garrettsworkshop/WarpSE/Documentation/Breakdown.png

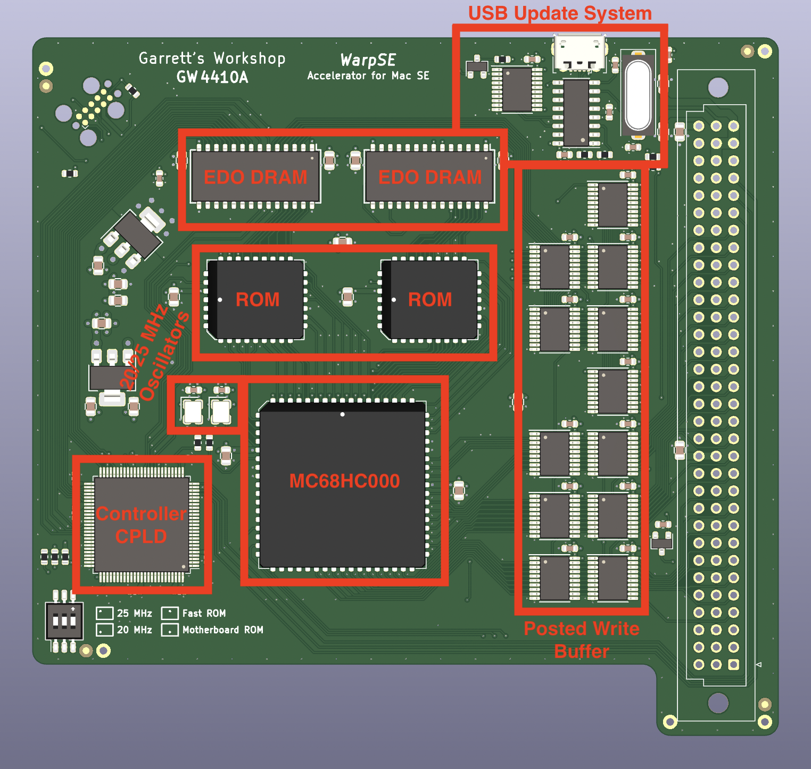
Documentation/Breakdown.png
