garrettsworkshop/WarpSE/Documentation/CPLD.png

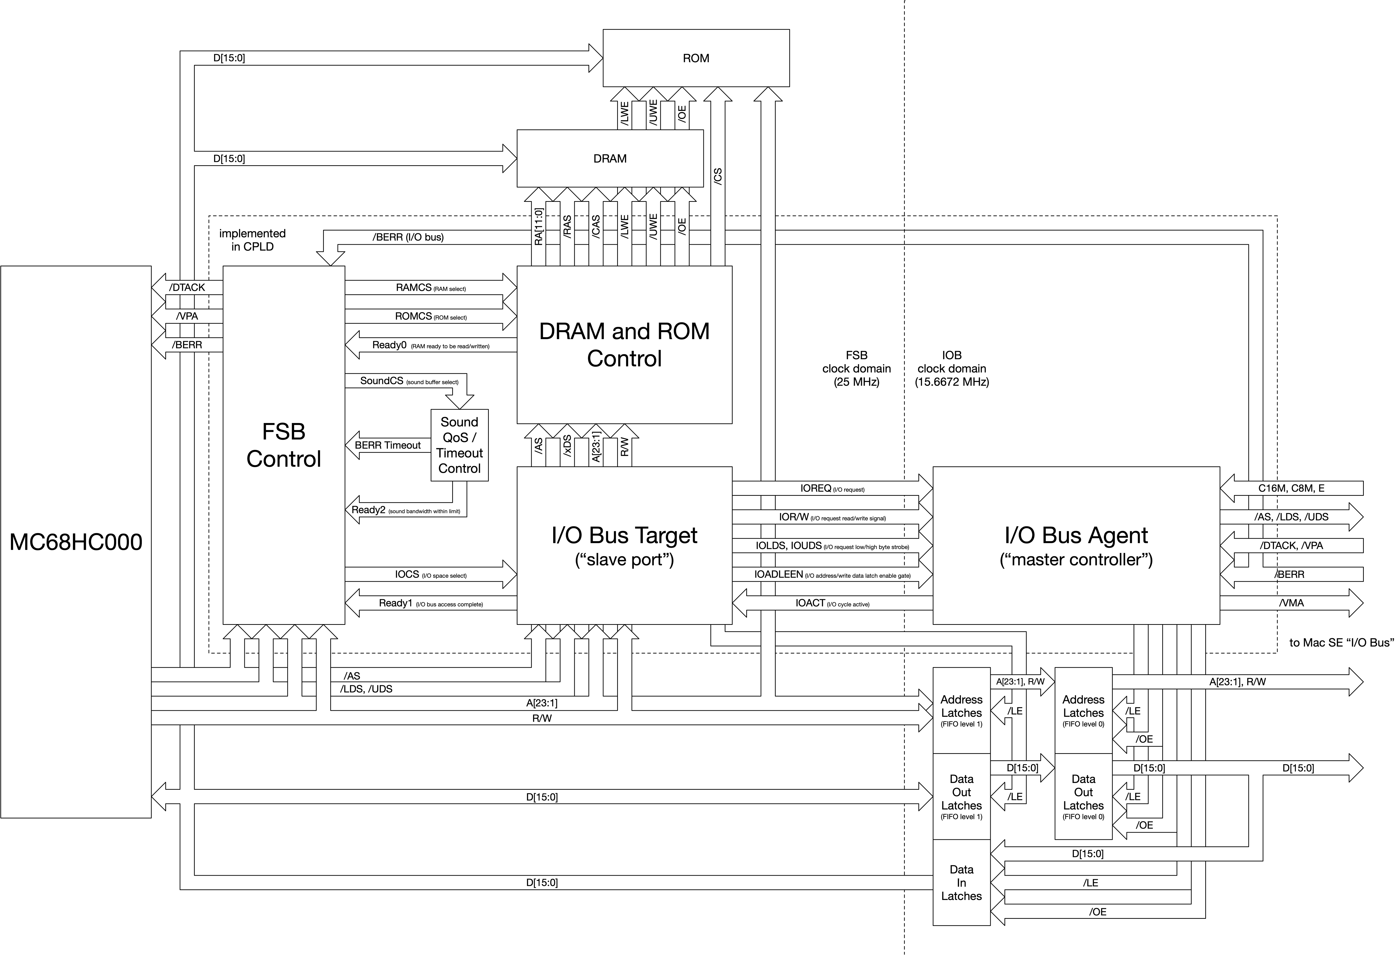
Documentation/CPLD.png
