garrettsworkshop/WarpSE/Documentation/FrontIsom.png

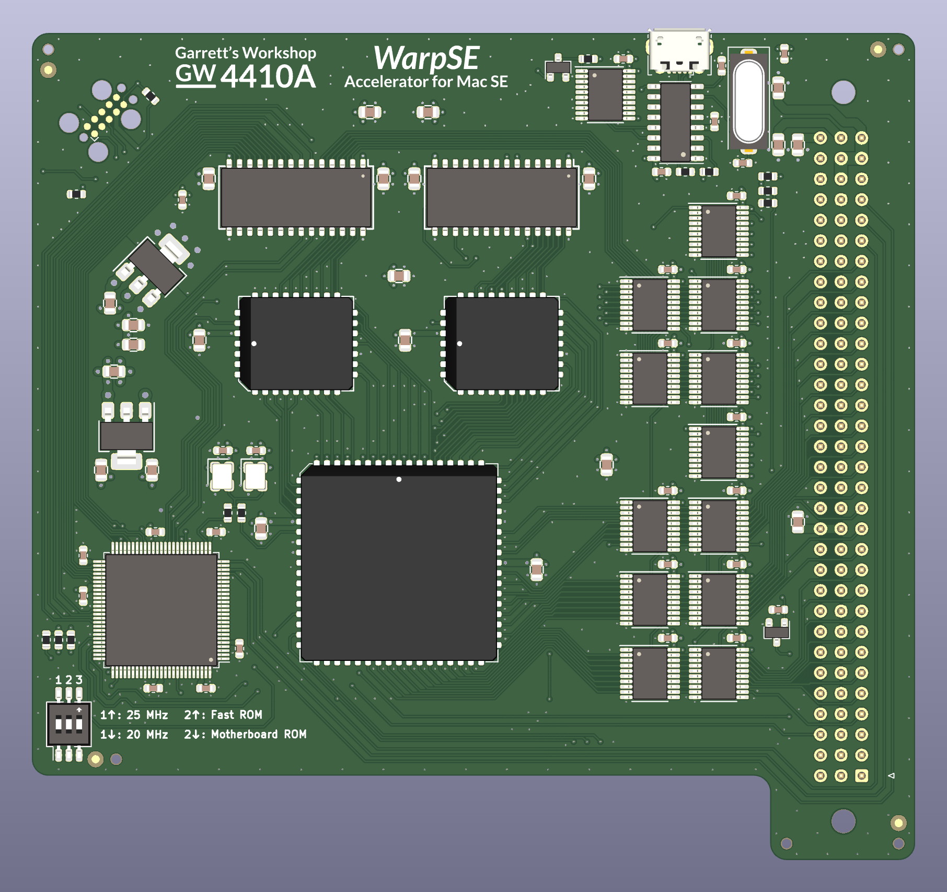
Documentation/FrontIsom.png
