garrettsworkshop/WarpSE/Documentation/WarpSE.4410A-Schematic.pdf

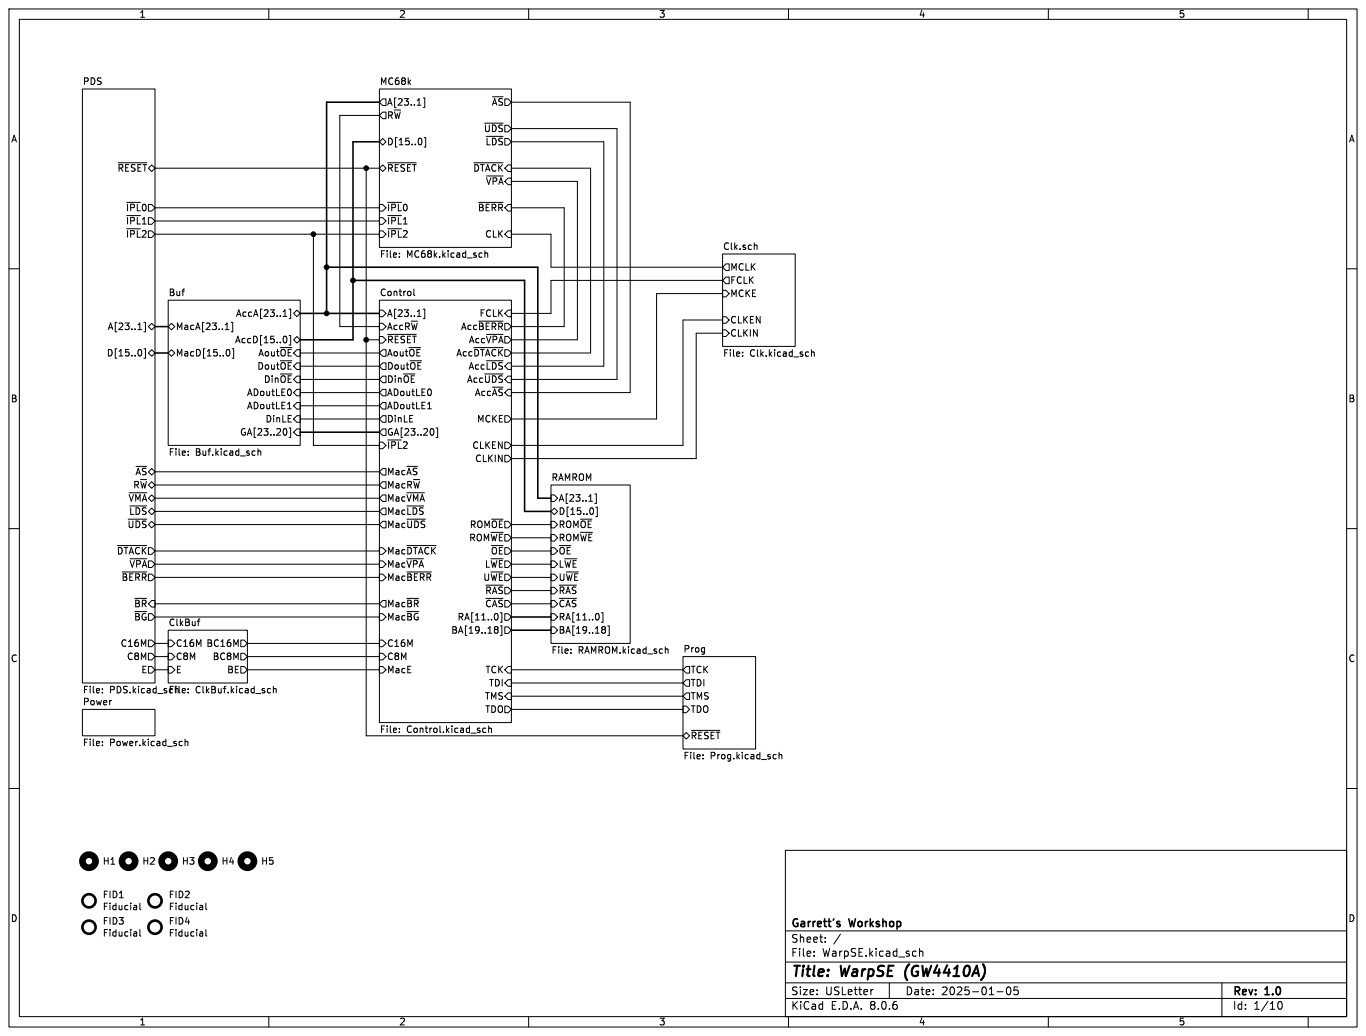
[picture p4: page 1]

Clk.sch File: Clk.kicad_sch A[23..1]
ClkBuf File: ClkBuf.kicad_sch AccA[23..1]
MacA[23..1]

Prog File: Prog.kicad_sch MCLK
FCLK MCKE CLKIN

Aout~{OE} ADoutLE0 ADoutLE1 GA[23..20] Buf File: Buf.kicad_sch A[23..1]

Aout~{OE}
ROM~{OE} DinLE Dout~{OE}
Din~{OE}

Id: 1/10 Title: WarpSE (GW4410A) File: WarpSE.kicad_sch Sheet: / Garrett's Workshop

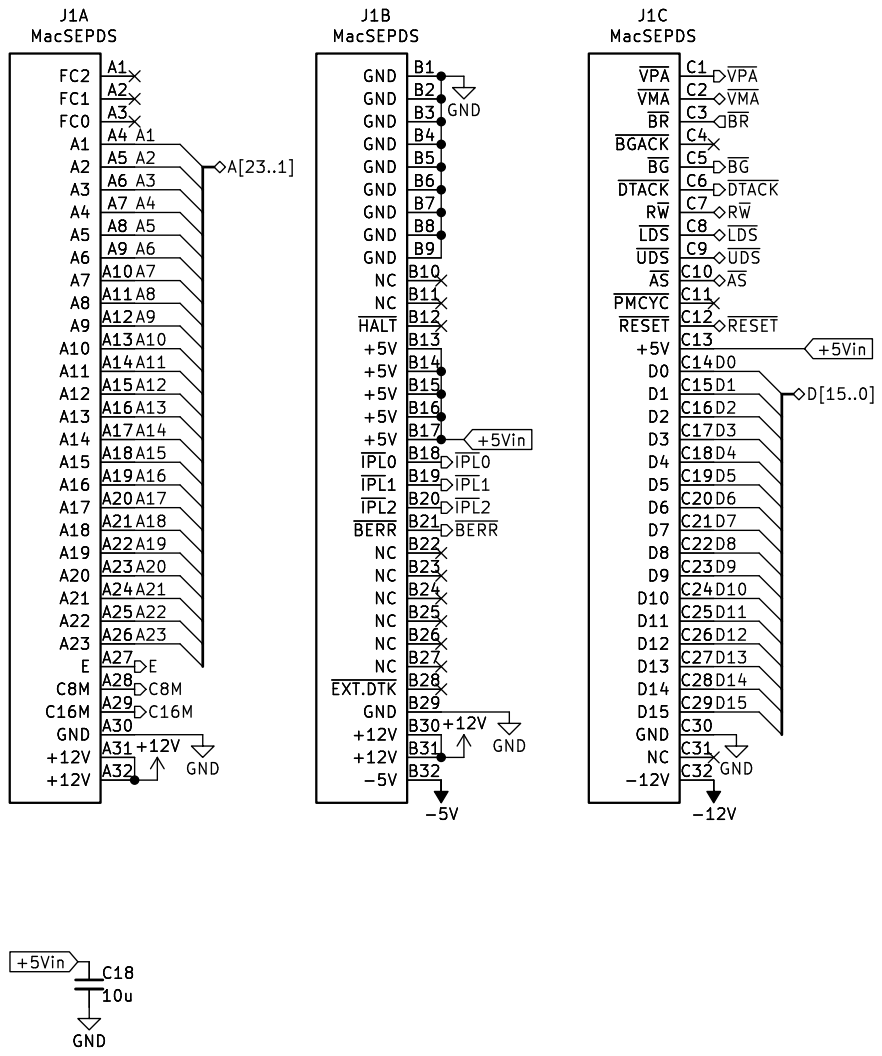
[picture p5: page 2]

Id: 2/10 Title: WarpSE (GW4410A) File: PDS.kicad_sch Sheet: /PDS/ Garrett's Workshop GND

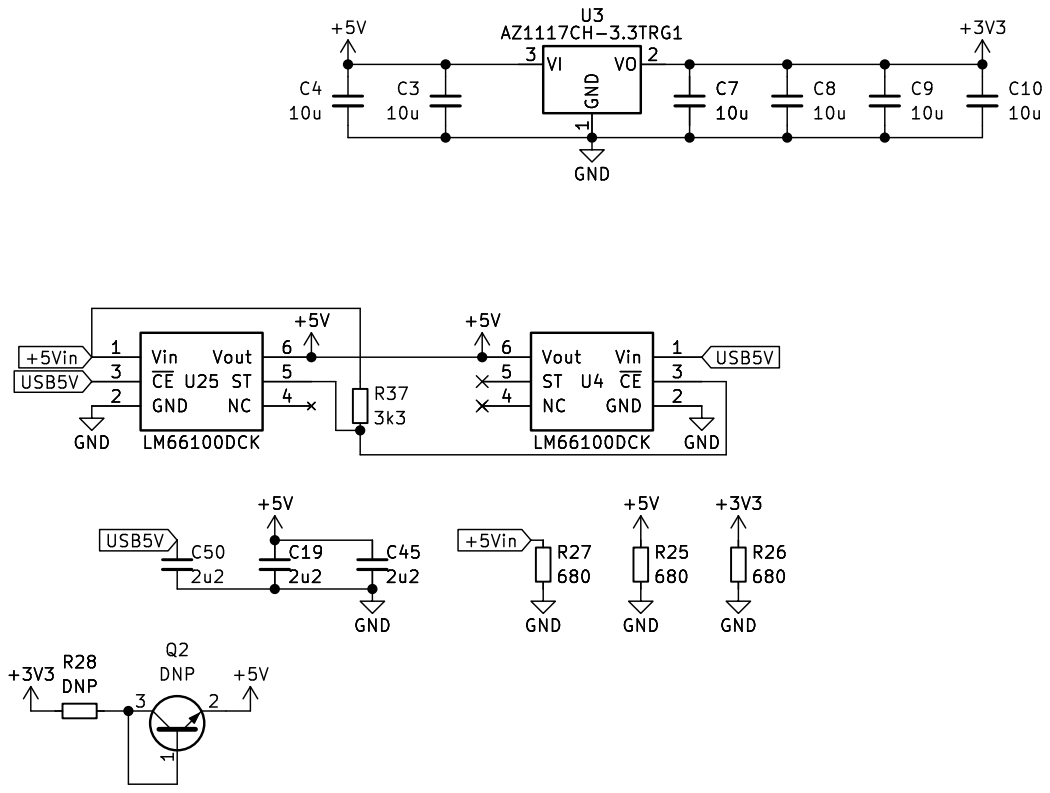
[picture p6: page 3]

Id: 3/10 Title: WarpSE (GW4410A) File: Power.kicad_sch Sheet: /Power/ Garrett's Workshop

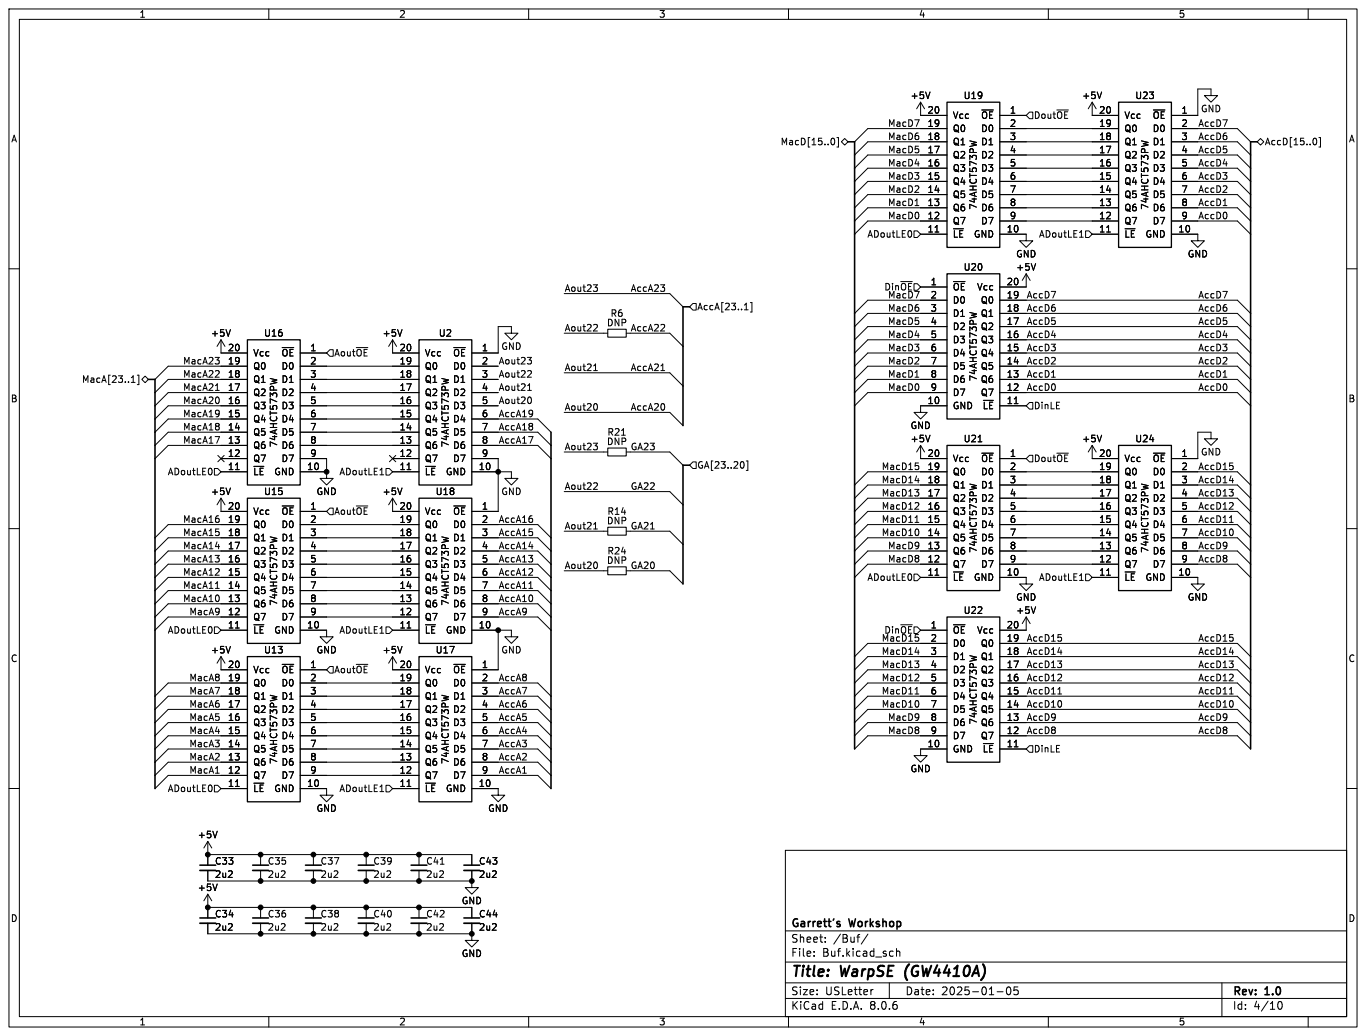
[picture p7: page 4]

Id: 4/10 Title: WarpSE (GW4410A) File: Buf.kicad_sch Sheet: /Buf/ Garrett's Workshop

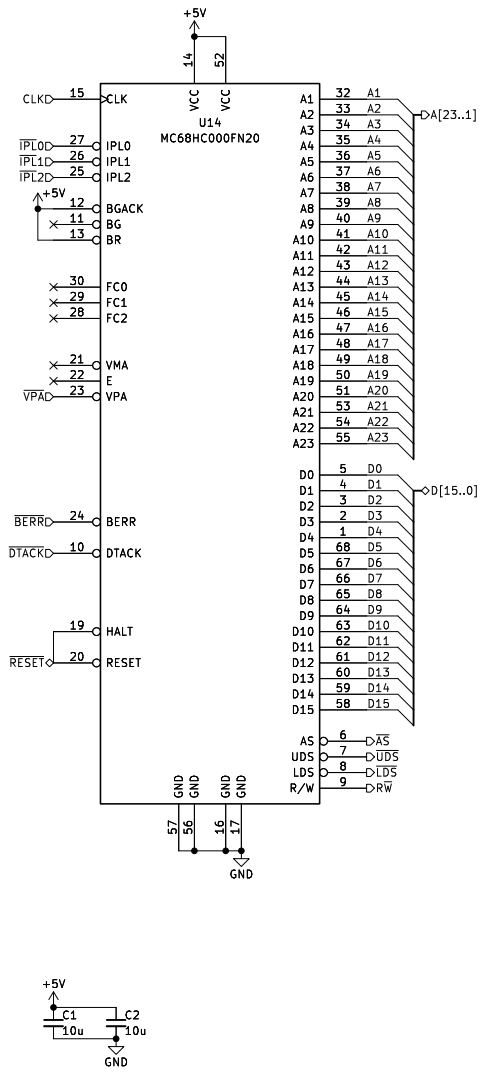
[picture p8: page 5]

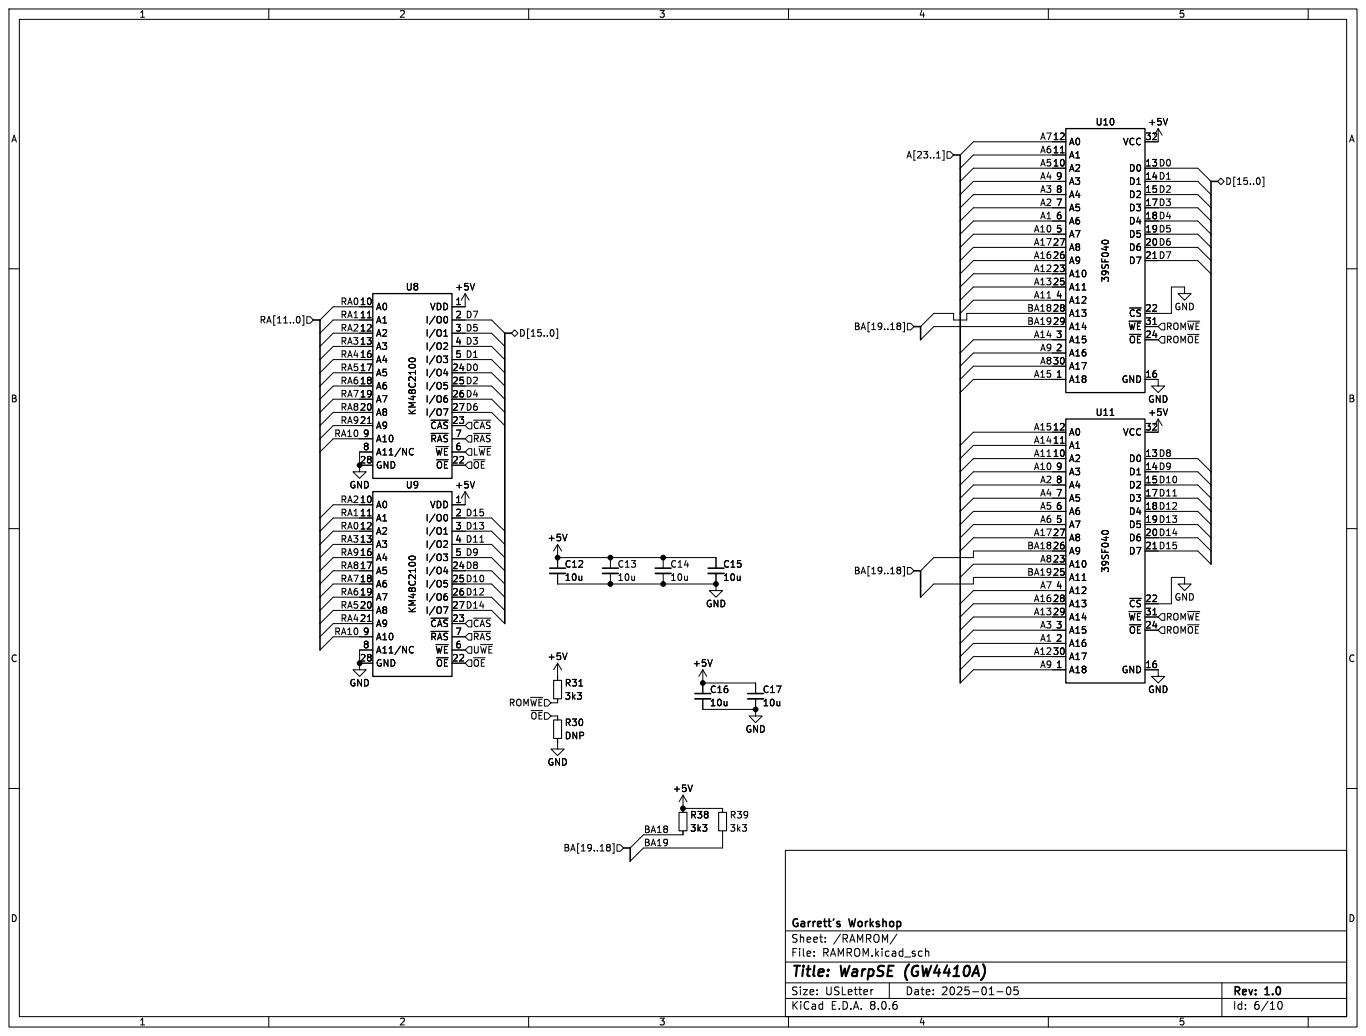
[picture p9: page 6]

Id: 6/10 Title: WarpSE (GW4410A) File: RAMROM.kicad_sch Sheet: /RAMROM/ Garrett's Workshop

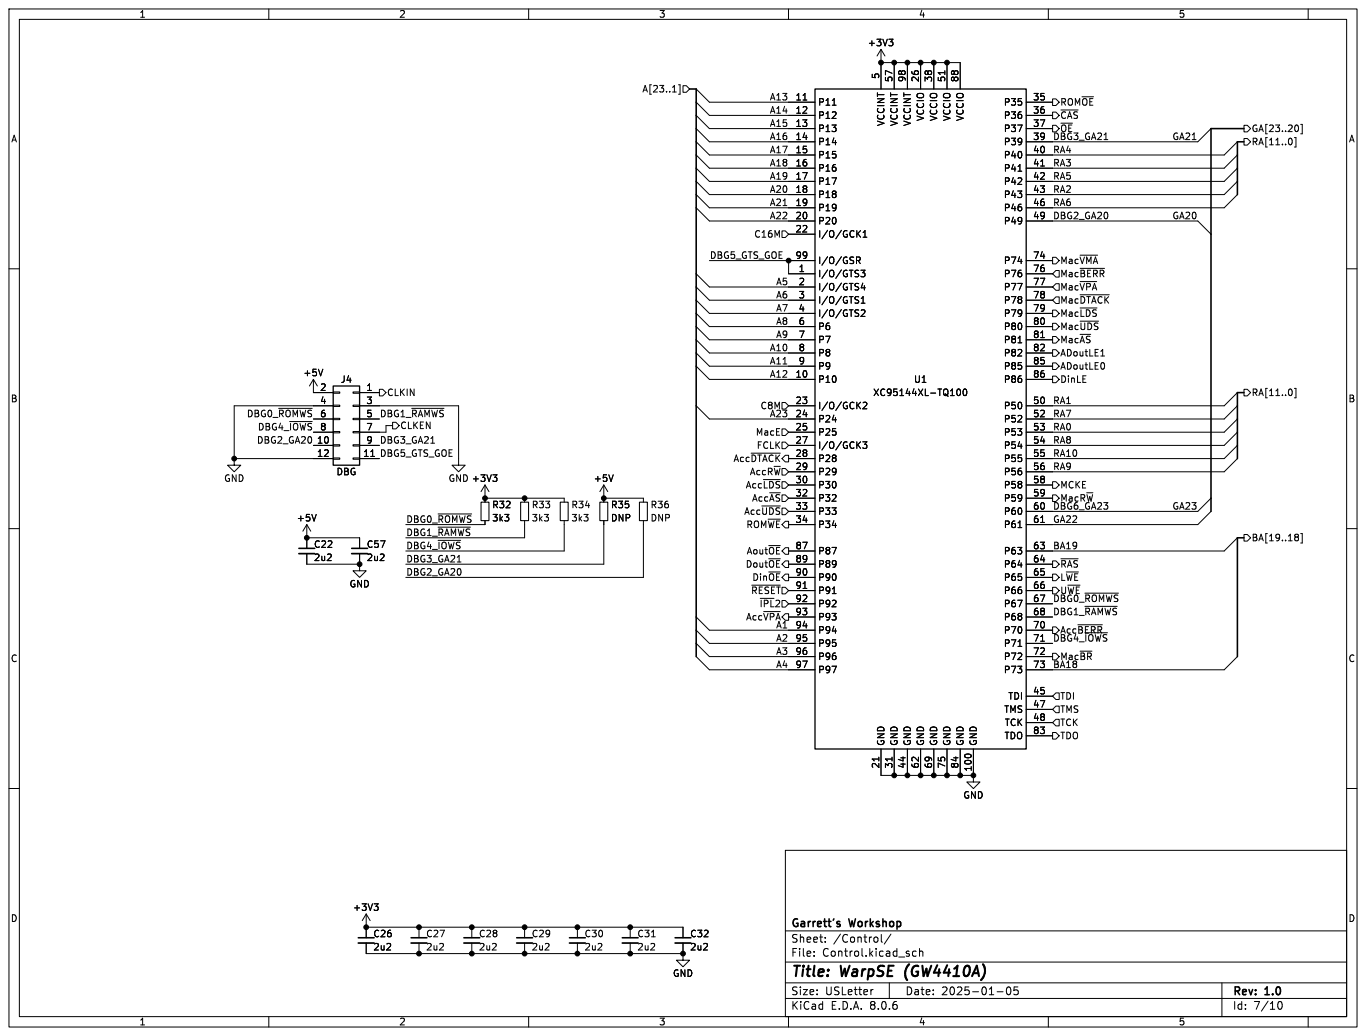
[picture p10: page 7]

Mac~{VMA}
Mac~{BERR} ADoutLE1 Mac~{LDS}
Mac~{VPA}
Mac~{DTACK}

BA[19..18] TDI Mac~{AS} TDO

Id: 7/10 Title: WarpSE (GW4410A) File: Control.kicad_sch Sheet: /Control/ Garrett's Workshop C27

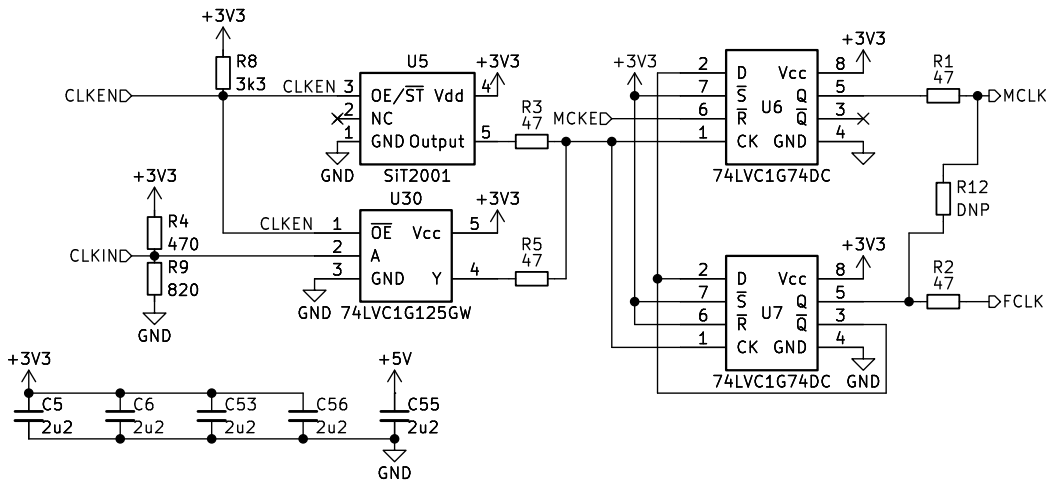
[picture p11: page 8]

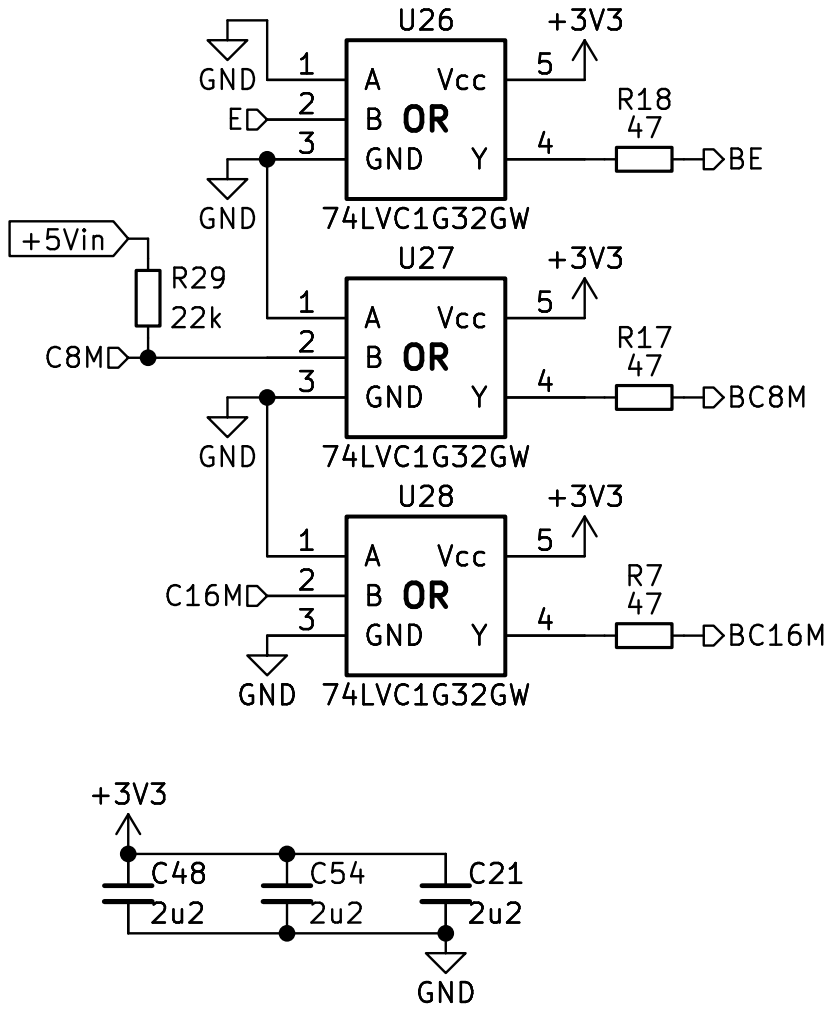
[picture p12: page 9]

74LVC1G32GW
Id: 10/10 Title: WarpSE (GW4410A) File: ClkBuf.kicad_sch Sheet: /ClkBuf/ Garrett's Workshop OR

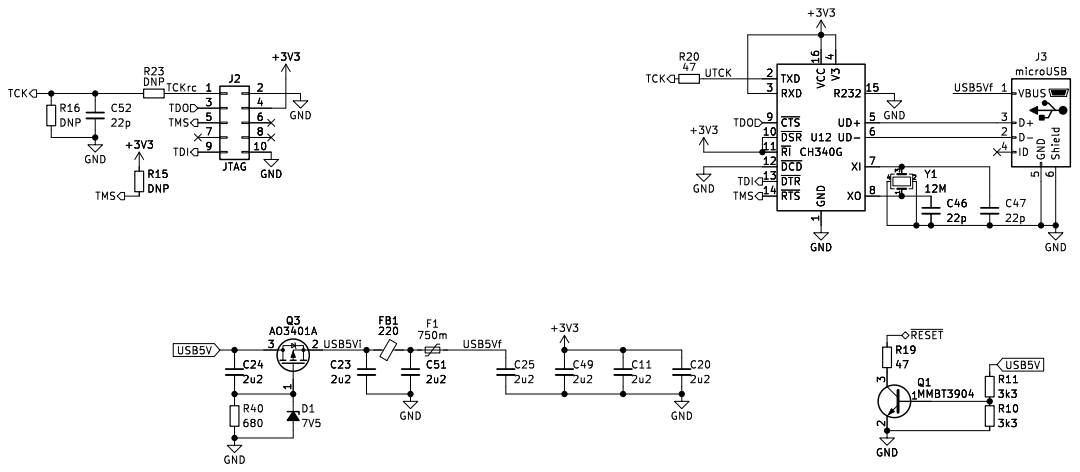
[picture p13: page 10]

1 ~{DSR} 10 ~{RI} 11 ~{DCD} 12 ~{DTR} 13 ~{RTS} 14 R232 VCC 15 16 TXD 2 RXD 3 V3

4 UD+ 5 UD- 6 XI 7 XO 8 ~{CTS} 9 U12 CH340G

4 UD+ 5 UD- 6 XI 7 XO 8 ~{CTS} 9

Id: 10/10 Title: WarpSE (GW4410A) File: Prog.kicad_sch Sheet: /Prog/ Garrett's Workshop
