garrettsworkshop/WarpSE/Documentation/WarpSE.4410A-Placement.pdf

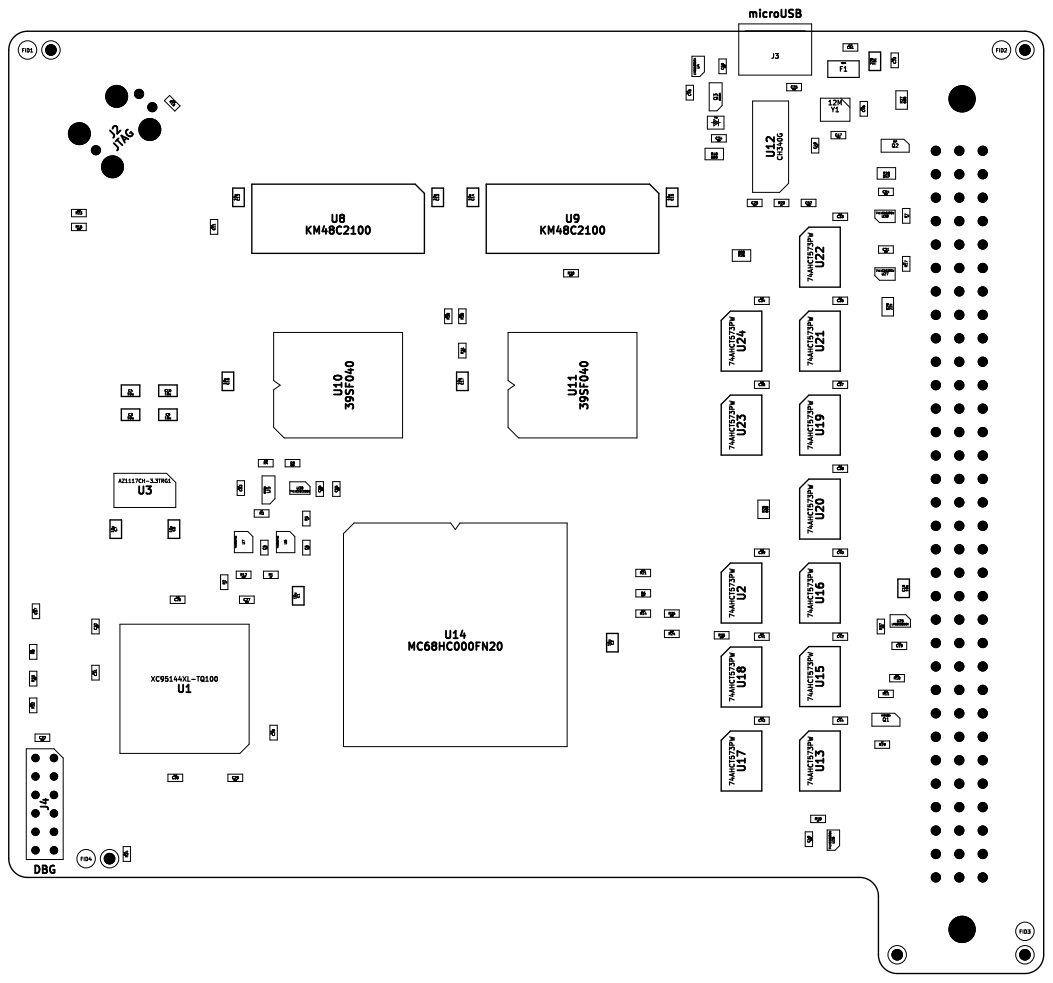
[picture p14: page 1]
