garrettsworkshop/WarpSE/WarpSE.kicad_pcb

## KiCad design WarpSE.kicad_pcb (2025-01-10)

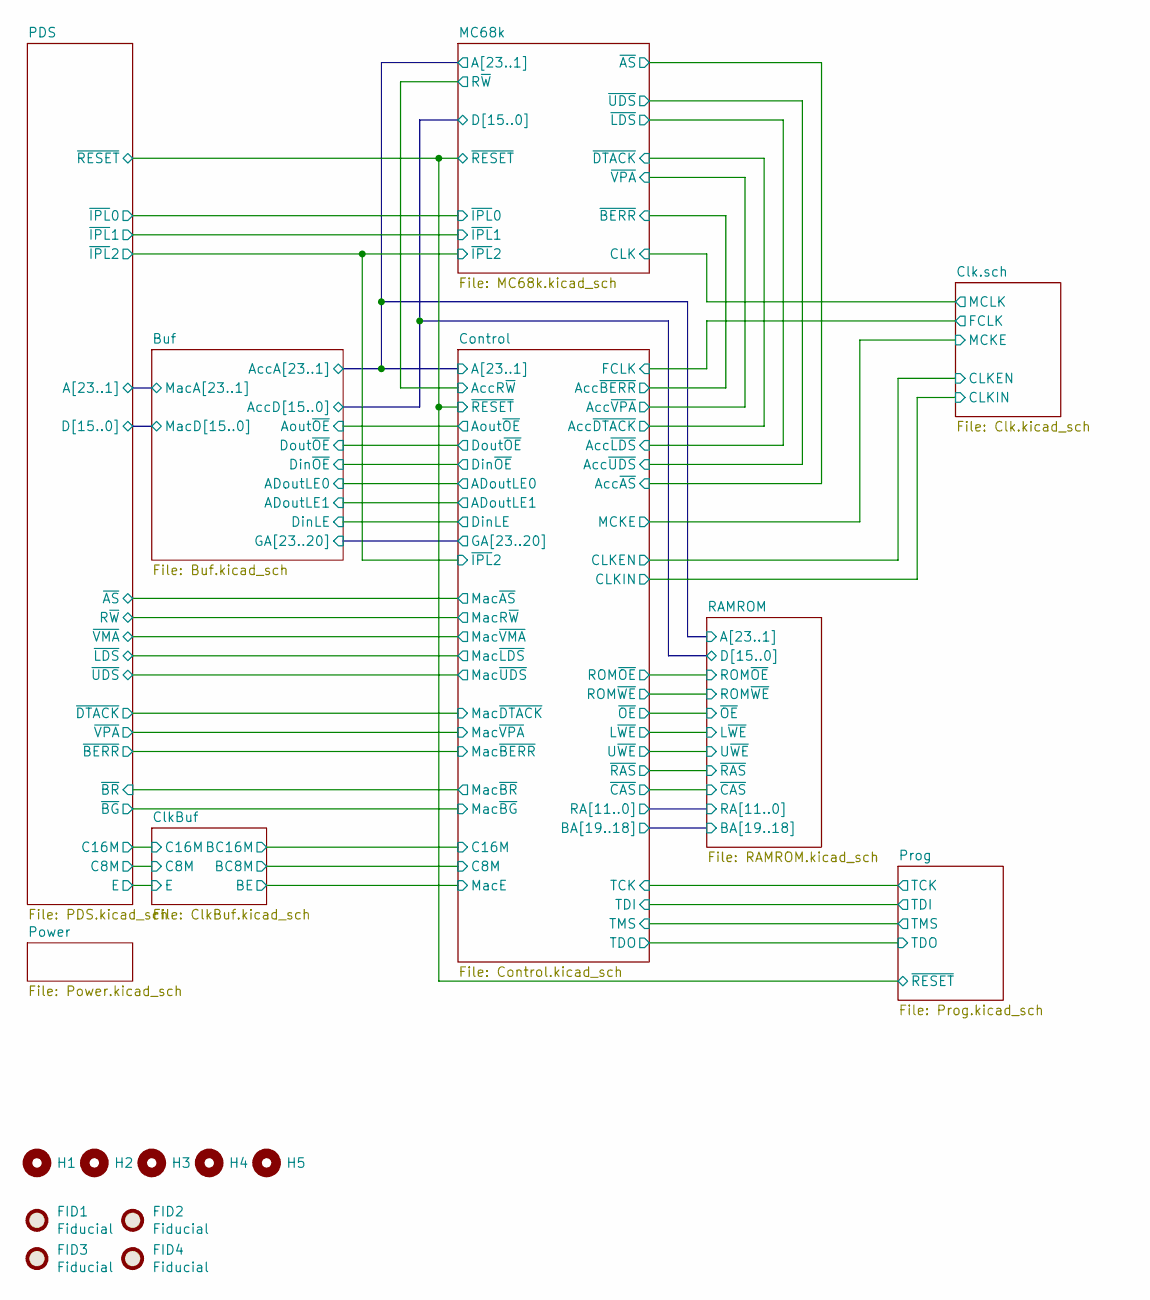
[picture p15: schematic WarpSE.kicad_sch, WarpSE (GW4410A)]

Parts:
FID1, FID2, FID3, FID4: Fiducial
H1, H2, H3, H4, H5: PasteHole_1.152mm_NPTH

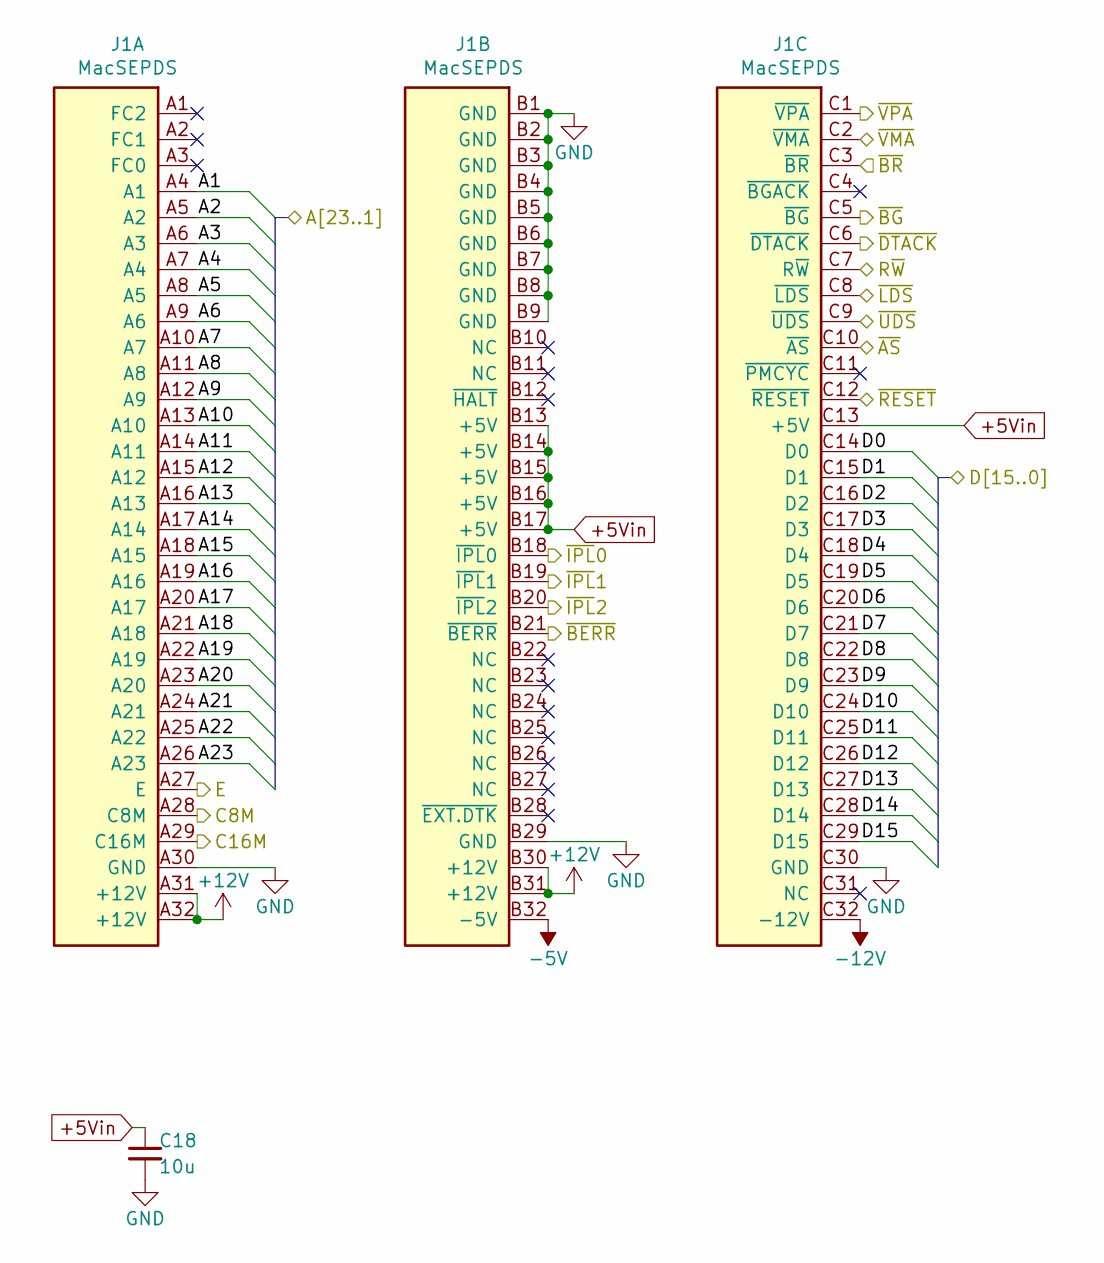
[picture p16: schematic PDS.kicad_sch, WarpSE (GW4410A)]

Parts:
C18: 10u; C_0805; LCSC Part C15850
J1: MacSEPDS; DIN41612_R_3x32_Male_Vertical_THT

Connections:
+5Vin: C18.1, J1.B13 (+5V), J1.B14 (+5V), J1.B15 (+5V), J1.B16 (+5V), J1.B17 (+5V), J1.C13 (+5V); also elsewhere on the board
+12V: J1.A31 (+12V), J1.A32 (+12V), J1.B30 (+12V), J1.B31 (+12V)
-5V: J1.B32 (-5V)
-12V: J1.C32 (-12V)
/Buf/MacA1: J1.A4 (A1); also elsewhere on the board
/Buf/MacA2: J1.A5 (A2); also elsewhere on the board
/Buf/MacA3: J1.A6 (A3); also elsewhere on the board
/Buf/MacA4: J1.A7 (A4); also elsewhere on the board
/Buf/MacA5: J1.A8 (A5); also elsewhere on the board
/Buf/MacA6: J1.A9 (A6); also elsewhere on the board
/Buf/MacA7: J1.A10 (A7); also elsewhere on the board
/Buf/MacA8: J1.A11 (A8); also elsewhere on the board
/Buf/MacA9: J1.A12 (A9); also elsewhere on the board
/Buf/MacA10: J1.A13 (A10); also elsewhere on the board
/Buf/MacA11: J1.A14 (A11); also elsewhere on the board
/Buf/MacA12: J1.A15 (A12); also elsewhere on the board
/Buf/MacA13: J1.A16 (A13); also elsewhere on the board
/Buf/MacA14: J1.A17 (A14); also elsewhere on the board
/Buf/MacA15: J1.A18 (A15); also elsewhere on the board
/Buf/MacA16: J1.A19 (A16); also elsewhere on the board
/Buf/MacA17: J1.A20 (A17); also elsewhere on the board
/Buf/MacA18: J1.A21 (A18); also elsewhere on the board
/Buf/MacA19: J1.A22 (A19); also elsewhere on the board
/Buf/MacA20: J1.A23 (A20); also elsewhere on the board
/Buf/MacA21: J1.A24 (A21); also elsewhere on the board
/Buf/MacA22: J1.A25 (A22); also elsewhere on the board
/Buf/MacA23: J1.A26 (A23); also elsewhere on the board
/Buf/MacD0: J1.C14 (D0); also elsewhere on the board
/Buf/MacD1: J1.C15 (D1); also elsewhere on the board
/Buf/MacD2: J1.C16 (D2); also elsewhere on the board
/Buf/MacD3: J1.C17 (D3); also elsewhere on the board
/Buf/MacD4: J1.C18 (D4); also elsewhere on the board
/Buf/MacD5: J1.C19 (D5); also elsewhere on the board
/Buf/MacD6: J1.C20 (D6); also elsewhere on the board
/Buf/MacD7: J1.C21 (D7); also elsewhere on the board
/Buf/MacD8: J1.C22 (D8); also elsewhere on the board
/Buf/MacD9: J1.C23 (D9); also elsewhere on the board
/Buf/MacD10: J1.C24 (D10); also elsewhere on the board
/Buf/MacD11: J1.C25 (D11); also elsewhere on the board
/Buf/MacD12: J1.C26 (D12); also elsewhere on the board
/Buf/MacD13: J1.C27 (D13); also elsewhere on the board
/Buf/MacD14: J1.C28 (D14); also elsewhere on the board
/Buf/MacD15: J1.C29 (D15); also elsewhere on the board
/ClkBuf/C8M: J1.A28 (C8M); also elsewhere on the board
/ClkBuf/C16M: J1.A29 (C16M); also elsewhere on the board
/ClkBuf/E: J1.A27 (E); also elsewhere on the board
/Control/MacR~W: J1.C7 (R~W); also elsewhere on the board
/Control/Mac~AS: J1.C10 (~AS); also elsewhere on the board
/Control/Mac~BERR: J1.B21 (~BERR); also elsewhere on the board
/Control/Mac~BR: J1.C3 (~BR); also elsewhere on the board
/Control/Mac~DTACK: J1.C6 (~DTACK); also elsewhere on the board
/Control/Mac~LDS: J1.C8 (~LDS); also elsewhere on the board
/Control/Mac~UDS: J1.C9 (~UDS); also elsewhere on the board
/Control/Mac~VMA: J1.C2 (~VMA); also elsewhere on the board
/Control/Mac~VPA: J1.C1 (~VPA); also elsewhere on the board
/Control/~IPL2: J1.B20 (~IPL2); also elsewhere on the board
/Control/~RESET: J1.C12 (~RESET); also elsewhere on the board
/MC68k/~IPL0: J1.B18 (~IPL0); also elsewhere on the board
/MC68k/~IPL1: J1.B19 (~IPL1); also elsewhere on the board
/PDS/~BG: J1.C5 (~BG)
GND: C18.2, J1.A30 (GND), J1.B1 (GND), J1.B2 (GND), J1.B3 (GND), J1.B4 (GND), J1.B5 (GND), J1.B6 (GND), J1.B7 (GND), J1.B8 (GND), J1.B9 (GND), J1.B29 (GND), J1.C30 (GND); also elsewhere on the board

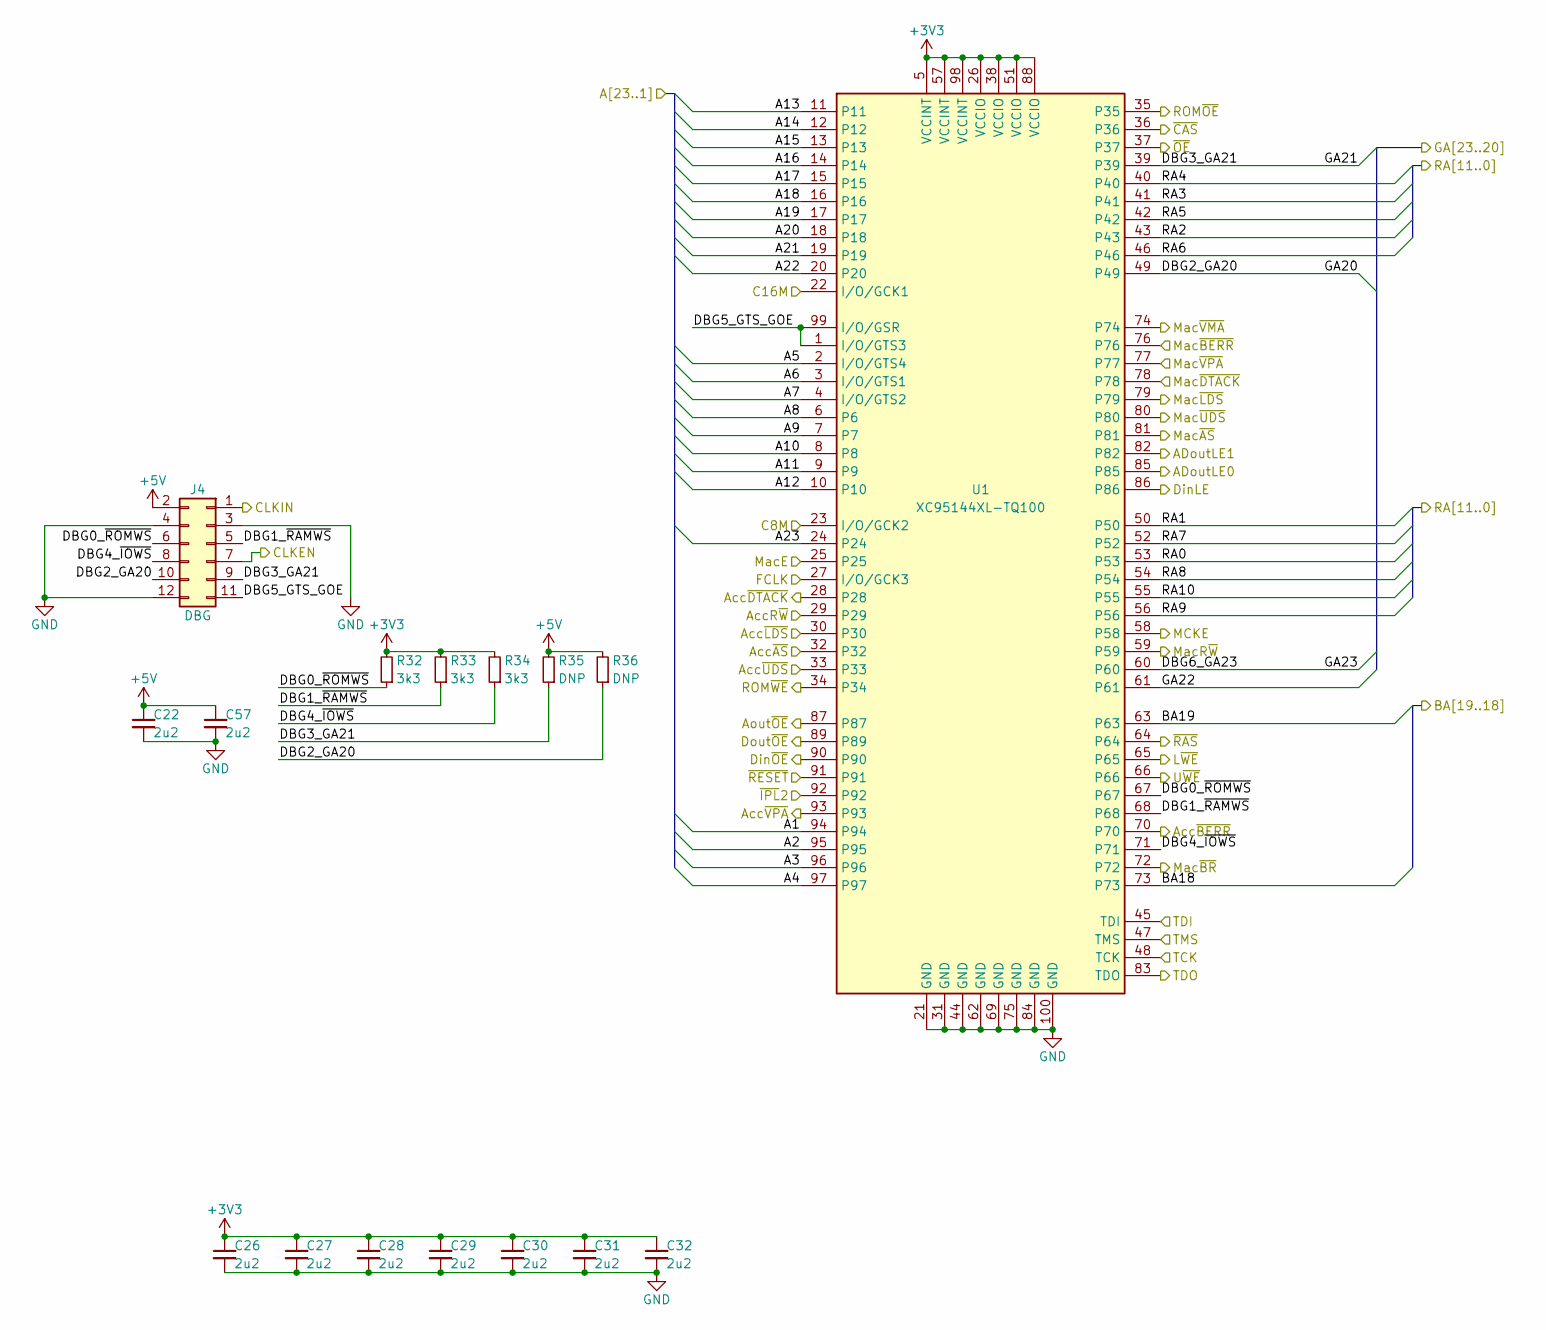
[picture p17: schematic Control.kicad_sch, WarpSE (GW4410A)]

Parts:
C22, C26, C27, C28, C29, C30, C31, C32, C57: 2u2; C_0603; LCSC Part C23630
J4: DBG; PinSocket_2x06_P2.00mm_Vertical
R32, R33, R34: 3k3; R_0603; LCSC Part C21190
R35, R36: DNP; R_0603
U1: XC95144XL-TQ100; TQFP-100_14x14mm_P0.5mm; LCSC Part C45126

Connections:
+3V3: C26.1, C27.1, C28.1, C29.1, C30.1, C31.1, C32.1, R32.2, R33.2, R34.2, U1.5 (VCCINT), U1.26 (VCCIO), U1.38 (VCCIO), U1.51 (VCCIO), U1.57 (VCCINT), U1.88 (VCCIO), U1.98 (VCCINT); also elsewhere on the board
+5V: C22.1, C57.1, J4.2, R35.2, R36.2; also elsewhere on the board
/Buf/ADoutLE0: U1.85; also elsewhere on the board
/Buf/ADoutLE1: U1.82; also elsewhere on the board
/Buf/AccA1: U1.94; also elsewhere on the board
/Buf/AccA2: U1.95; also elsewhere on the board
/Buf/AccA3: U1.96; also elsewhere on the board
/Buf/AccA4: U1.97; also elsewhere on the board
/Buf/AccA5: U1.2 (I/O/GTS4); also elsewhere on the board
/Buf/AccA6: U1.3 (I/O/GTS1); also elsewhere on the board
/Buf/AccA7: U1.4 (I/O/GTS2); also elsewhere on the board
/Buf/AccA8: U1.6; also elsewhere on the board
/Buf/AccA9: U1.7; also elsewhere on the board
/Buf/AccA10: U1.8; also elsewhere on the board
/Buf/AccA11: U1.9; also elsewhere on the board
/Buf/AccA12: U1.10; also elsewhere on the board
/Buf/AccA13: U1.11; also elsewhere on the board
/Buf/AccA14: U1.12; also elsewhere on the board
/Buf/AccA15: U1.13; also elsewhere on the board
/Buf/AccA16: U1.14; also elsewhere on the board
/Buf/AccA17: U1.15; also elsewhere on the board
/Buf/AccA18: U1.16; also elsewhere on the board
/Buf/AccA19: U1.17; also elsewhere on the board
/Buf/AccA20: U1.18; also elsewhere on the board
/Buf/AccA21: U1.19; also elsewhere on the board
/Buf/AccA22: U1.20; also elsewhere on the board
/Buf/AccA23: U1.24; also elsewhere on the board
/Buf/Aout~OE: U1.87; also elsewhere on the board
/Buf/DinLE: U1.86; also elsewhere on the board
/Buf/Din~OE: U1.90; also elsewhere on the board
/Buf/Dout~OE: U1.89; also elsewhere on the board
/Buf/GA20: J4.10, R36.1, U1.49; also elsewhere on the board
/Buf/GA21: J4.9, R35.1, U1.39; also elsewhere on the board
/Buf/GA22: U1.61; also elsewhere on the board
/Buf/GA23: U1.60; also elsewhere on the board
/Clk.sch/CLKEN: J4.7; also elsewhere on the board
/Clk.sch/CLKIN: J4.1; also elsewhere on the board
/Clk.sch/FCLK: U1.27 (I/O/GCK3); also elsewhere on the board
/Clk.sch/MCKE: U1.58; also elsewhere on the board
/ClkBuf/BC8M: U1.23 (I/O/GCK2); also elsewhere on the board
/ClkBuf/BC16M: U1.22 (I/O/GCK1); also elsewhere on the board
/ClkBuf/BE: U1.25; also elsewhere on the board
/Control/AccR~W: U1.29; also elsewhere on the board
/Control/Acc~AS: U1.32; also elsewhere on the board
/Control/Acc~BERR: U1.70; also elsewhere on the board
/Control/Acc~DTACK: U1.28; also elsewhere on the board
/Control/Acc~LDS: U1.30; also elsewhere on the board
/Control/Acc~UDS: U1.33; also elsewhere on the board
/Control/Acc~VPA: U1.93; also elsewhere on the board
/Control/BA18: U1.73; also elsewhere on the board
/Control/BA19: U1.63; also elsewhere on the board
/Control/DBG0_~ROMWS: J4.6, R32.1, U1.67
/Control/DBG1_~RAMWS: J4.5, R33.1, U1.68
/Control/DBG4_~IOWS: J4.8, R34.1, U1.71
/Control/DBG5_GTS_GOE: J4.11, U1.1 (I/O/GTS3), U1.99 (I/O/GSR)
/Control/L~WE: U1.65; also elsewhere on the board
/Control/MacR~W: U1.59; also elsewhere on the board
/Control/Mac~AS: U1.81; also elsewhere on the board
/Control/Mac~BERR: U1.76; also elsewhere on the board
/Control/Mac~BR: U1.72; also elsewhere on the board
/Control/Mac~DTACK: U1.78; also elsewhere on the board
/Control/Mac~LDS: U1.79; also elsewhere on the board
/Control/Mac~UDS: U1.80; also elsewhere on the board
/Control/Mac~VMA: U1.74; also elsewhere on the board
/Control/Mac~VPA: U1.77; also elsewhere on the board
/Control/RA0: U1.53; also elsewhere on the board
/Control/RA1: U1.50; also elsewhere on the board
/Control/RA2: U1.43; also elsewhere on the board
/Control/RA3: U1.41; also elsewhere on the board
/Control/RA4: U1.40; also elsewhere on the board
/Control/RA5: U1.42; also elsewhere on the board
/Control/RA6: U1.46; also elsewhere on the board
/Control/RA7: U1.52; also elsewhere on the board
/Control/RA8: U1.54; also elsewhere on the board
/Control/RA9: U1.56; also elsewhere on the board
/Control/RA10: U1.55; also elsewhere on the board
/Control/ROM~OE: U1.35; also elsewhere on the board
/Control/ROM~WE: U1.34; also elsewhere on the board
/Control/TCK: U1.48 (TCK); also elsewhere on the board
/Control/TDI: U1.45 (TDI); also elsewhere on the board
/Control/TDO: U1.83 (TDO); also elsewhere on the board
/Control/TMS: U1.47 (TMS); also elsewhere on the board
/Control/U~WE: U1.66; also elsewhere on the board
/Control/~CAS: U1.36; also elsewhere on the board
/Control/~IPL2: U1.92; also elsewhere on the board
/Control/~OE: U1.37; also elsewhere on the board
/Control/~RAS: U1.64; also elsewhere on the board
/Control/~RESET: U1.91; also elsewhere on the board
GND: C22.2, C26.2, C27.2, C28.2, C29.2, C30.2, C31.2, C32.2, C57.2, J4.3, J4.4, J4.12, U1.21 (GND), U1.31 (GND), U1.44 (GND), U1.62 (GND), U1.69 (GND), U1.75 (GND), U1.84 (GND), U1.100 (GND); also elsewhere on the board

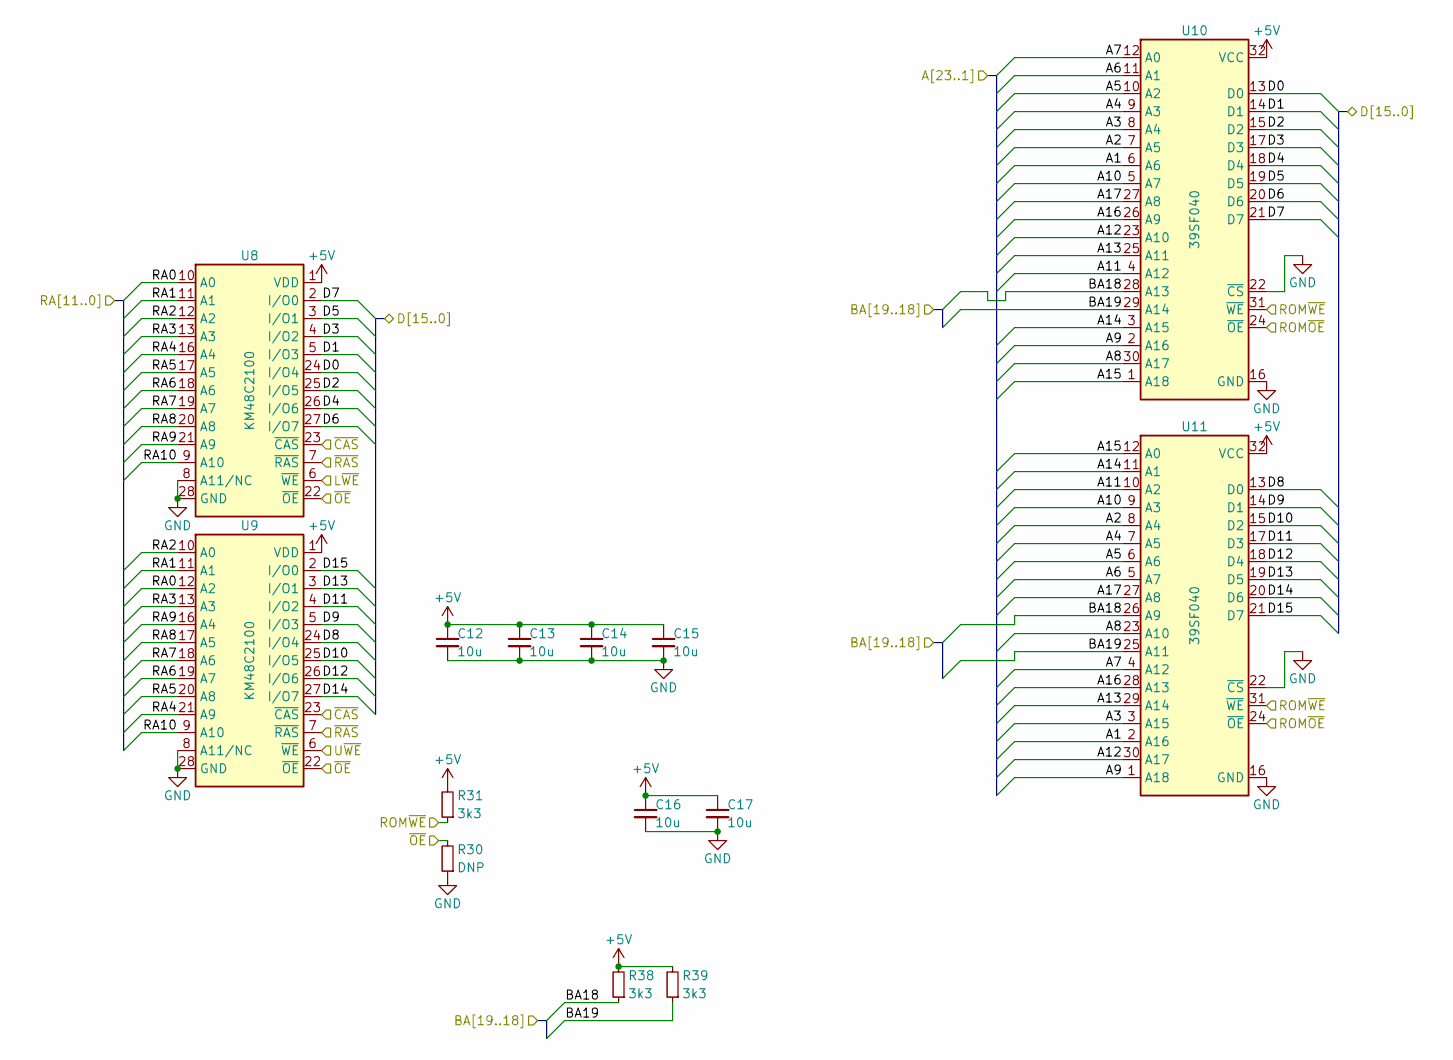
[picture p18: schematic RAMROM.kicad_sch, WarpSE (GW4410A)]

Parts:
C12, C13, C14, C15, C16, C17: 10u; C_0805; LCSC Part C15850
R30: DNP; R_0603
R31, R38, R39: 3k3; R_0603; LCSC Part C21190
U8, U9: KM48C2100; SOJ-28_300mil
U10, U11: 39SF040; PLCC-32; LCSC Part C645935

Connections:
+5V: C12.1, C13.1, C14.1, C15.1, C16.1, C17.1, R31.2, R38.2, R39.2, U8.1 (VDD), U8.14 (VDD), U9.1 (VDD), U9.14 (VDD), U10.32 (VCC), U11.32 (VCC); also elsewhere on the board
/Buf/AccA1: U10.6 (A6), U11.2 (A16); also elsewhere on the board
/Buf/AccA2: U10.7 (A5), U11.8 (A4); also elsewhere on the board
/Buf/AccA3: U10.8 (A4), U11.3 (A15); also elsewhere on the board
/Buf/AccA4: U10.9 (A3), U11.7 (A5); also elsewhere on the board
/Buf/AccA5: U10.10 (A2), U11.6 (A6); also elsewhere on the board
/Buf/AccA6: U10.11 (A1), U11.5 (A7); also elsewhere on the board
/Buf/AccA7: U10.12 (A0), U11.4 (A12); also elsewhere on the board
/Buf/AccA8: U10.30 (A17), U11.23 (A10); also elsewhere on the board
/Buf/AccA9: U10.2 (A16), U11.1 (A18); also elsewhere on the board
/Buf/AccA10: U10.5 (A7), U11.9 (A3); also elsewhere on the board
/Buf/AccA11: U10.4 (A12), U11.10 (A2); also elsewhere on the board
/Buf/AccA12: U10.23 (A10), U11.30 (A17); also elsewhere on the board
/Buf/AccA13: U10.25 (A11), U11.29 (A14); also elsewhere on the board
/Buf/AccA14: U10.3 (A15), U11.11 (A1); also elsewhere on the board
/Buf/AccA15: U10.1 (A18), U11.12 (A0); also elsewhere on the board
/Buf/AccA16: U10.26 (A9), U11.28 (A13); also elsewhere on the board
/Buf/AccA17: U10.27 (A8), U11.27 (A8); also elsewhere on the board
/Buf/AccD0: U8.24 (I/O4), U10.13 (D0); also elsewhere on the board
/Buf/AccD1: U8.5 (I/O3), U10.14 (D1); also elsewhere on the board
/Buf/AccD2: U8.25 (I/O5), U10.15 (D2); also elsewhere on the board
/Buf/AccD3: U8.4 (I/O2), U10.17 (D3); also elsewhere on the board
/Buf/AccD4: U8.26 (I/O6), U10.18 (D4); also elsewhere on the board
/Buf/AccD5: U8.3 (I/O1), U10.19 (D5); also elsewhere on the board
/Buf/AccD6: U8.27 (I/O7), U10.20 (D6); also elsewhere on the board
/Buf/AccD7: U8.2 (I/O0), U10.21 (D7); also elsewhere on the board
/Buf/AccD8: U9.24 (I/O4), U11.13 (D0); also elsewhere on the board
/Buf/AccD9: U9.5 (I/O3), U11.14 (D1); also elsewhere on the board
/Buf/AccD10: U9.25 (I/O5), U11.15 (D2); also elsewhere on the board
/Buf/AccD11: U9.4 (I/O2), U11.17 (D3); also elsewhere on the board
/Buf/AccD12: U9.26 (I/O6), U11.18 (D4); also elsewhere on the board
/Buf/AccD13: U9.3 (I/O1), U11.19 (D5); also elsewhere on the board
/Buf/AccD14: U9.27 (I/O7), U11.20 (D6); also elsewhere on the board
/Buf/AccD15: U9.2 (I/O0), U11.21 (D7); also elsewhere on the board
/Control/BA18: R38.1, U10.28 (A13), U11.26 (A9); also elsewhere on the board
/Control/BA19: R39.1, U10.29 (A14), U11.25 (A11); also elsewhere on the board
/Control/L~WE: U8.6 (~WE); also elsewhere on the board
/Control/RA0: U8.10 (A0), U9.12 (A2); also elsewhere on the board
/Control/RA1: U8.11 (A1), U9.11 (A1); also elsewhere on the board
/Control/RA2: U8.12 (A2), U9.10 (A0); also elsewhere on the board
/Control/RA3: U8.13 (A3), U9.13 (A3); also elsewhere on the board
/Control/RA4: U8.16 (A4), U9.21 (A9); also elsewhere on the board
/Control/RA5: U8.17 (A5), U9.20 (A8); also elsewhere on the board
/Control/RA6: U8.18 (A6), U9.19 (A7); also elsewhere on the board
/Control/RA7: U8.19 (A7), U9.18 (A6); also elsewhere on the board
/Control/RA8: U8.20 (A8), U9.17 (A5); also elsewhere on the board
/Control/RA9: U8.21 (A9), U9.16 (A4); also elsewhere on the board
/Control/RA10: U8.9 (A10), U9.9 (A10); also elsewhere on the board
/Control/ROM~OE: U10.24 (~OE), U11.24 (~OE); also elsewhere on the board
/Control/ROM~WE: R31.1, U10.31 (~WE), U11.31 (~WE); also elsewhere on the board
/Control/U~WE: U9.6 (~WE); also elsewhere on the board
/Control/~CAS: U8.23 (~CAS), U9.23 (~CAS); also elsewhere on the board
/Control/~OE: R30.2, U8.22 (~OE), U9.22 (~OE); also elsewhere on the board
/Control/~RAS: U8.7 (~RAS), U9.7 (~RAS); also elsewhere on the board
GND: C12.2, C13.2, C14.2, C15.2, C16.2, C17.2, R30.1, U8.8 (A11/NC), U8.15 (GND), U8.28 (GND), U9.8 (A11/NC), U9.15 (GND), U9.28 (GND), U10.16 (GND), U10.22 (~CS), U11.16 (GND), U11.22 (~CS); also elsewhere on the board

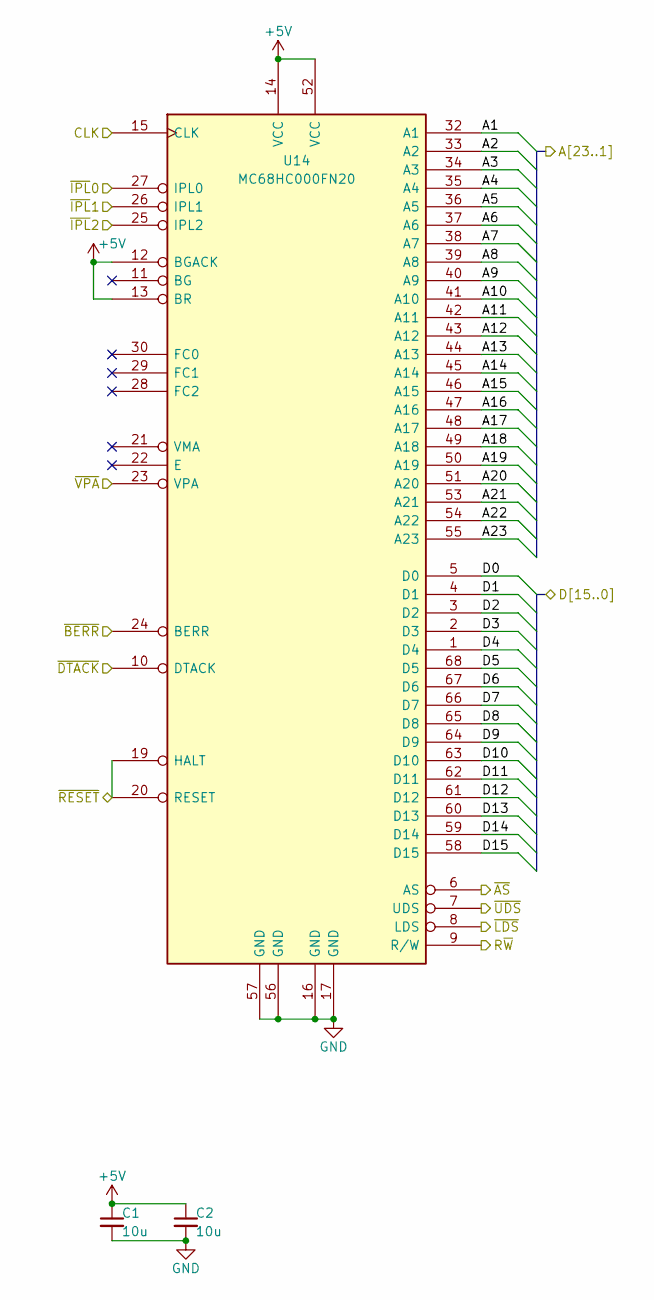
[picture p19: schematic MC68k.kicad_sch, WarpSE (GW4410A)]

Parts:
C1, C2: 10u; C_0805; LCSC Part C15850
U14: MC68HC000FN20; PLCC-68

Connections:
+5V: C1.1, C2.1, U14.12 (BGACK), U14.13 (BR), U14.14 (VCC), U14.52 (VCC); also elsewhere on the board
/Buf/AccA1: U14.32 (A1); also elsewhere on the board
/Buf/AccA2: U14.33 (A2); also elsewhere on the board
/Buf/AccA3: U14.34 (A3); also elsewhere on the board
/Buf/AccA4: U14.35 (A4); also elsewhere on the board
/Buf/AccA5: U14.36 (A5); also elsewhere on the board
/Buf/AccA6: U14.37 (A6); also elsewhere on the board
/Buf/AccA7: U14.38 (A7); also elsewhere on the board
/Buf/AccA8: U14.39 (A8); also elsewhere on the board
/Buf/AccA9: U14.40 (A9); also elsewhere on the board
/Buf/AccA10: U14.41 (A10); also elsewhere on the board
/Buf/AccA11: U14.42 (A11); also elsewhere on the board
/Buf/AccA12: U14.43 (A12); also elsewhere on the board
/Buf/AccA13: U14.44 (A13); also elsewhere on the board
/Buf/AccA14: U14.45 (A14); also elsewhere on the board
/Buf/AccA15: U14.46 (A15); also elsewhere on the board
/Buf/AccA16: U14.47 (A16); also elsewhere on the board
/Buf/AccA17: U14.48 (A17); also elsewhere on the board
/Buf/AccA18: U14.49 (A18); also elsewhere on the board
/Buf/AccA19: U14.50 (A19); also elsewhere on the board
/Buf/AccA20: U14.51 (A20); also elsewhere on the board
/Buf/AccA21: U14.53 (A21); also elsewhere on the board
/Buf/AccA22: U14.54 (A22); also elsewhere on the board
/Buf/AccA23: U14.55 (A23); also elsewhere on the board
/Buf/AccD0: U14.5 (D0); also elsewhere on the board
/Buf/AccD1: U14.4 (D1); also elsewhere on the board
/Buf/AccD2: U14.3 (D2); also elsewhere on the board
/Buf/AccD3: U14.2 (D3); also elsewhere on the board
/Buf/AccD4: U14.1 (D4); also elsewhere on the board
/Buf/AccD5: U14.68 (D5); also elsewhere on the board
/Buf/AccD6: U14.67 (D6); also elsewhere on the board
/Buf/AccD7: U14.66 (D7); also elsewhere on the board
/Buf/AccD8: U14.65 (D8); also elsewhere on the board
/Buf/AccD9: U14.64 (D9); also elsewhere on the board
/Buf/AccD10: U14.63 (D10); also elsewhere on the board
/Buf/AccD11: U14.62 (D11); also elsewhere on the board
/Buf/AccD12: U14.61 (D12); also elsewhere on the board
/Buf/AccD13: U14.60 (D13); also elsewhere on the board
/Buf/AccD14: U14.59 (D14); also elsewhere on the board
/Buf/AccD15: U14.58 (D15); also elsewhere on the board
/Clk.sch/MCLK: U14.15 (CLK); also elsewhere on the board
/Control/AccR~W: U14.9 (R/W); also elsewhere on the board
/Control/Acc~AS: U14.6 (AS); also elsewhere on the board
/Control/Acc~BERR: U14.24 (BERR); also elsewhere on the board
/Control/Acc~DTACK: U14.10 (DTACK); also elsewhere on the board
/Control/Acc~LDS: U14.8 (LDS); also elsewhere on the board
/Control/Acc~UDS: U14.7 (UDS); also elsewhere on the board
/Control/Acc~VPA: U14.23 (VPA); also elsewhere on the board
/Control/~IPL2: U14.25 (IPL2); also elsewhere on the board
/Control/~RESET: U14.19 (HALT), U14.20 (RESET); also elsewhere on the board
/MC68k/~IPL0: U14.27 (IPL0); also elsewhere on the board
/MC68k/~IPL1: U14.26 (IPL1); also elsewhere on the board
GND: C1.2, C2.2, U14.16 (GND), U14.17 (GND), U14.56 (GND), U14.57 (GND); also elsewhere on the board
