garrettsworkshop/WarpSE/WarpSE.kicad_pcb

## KiCad design WarpSE.kicad_pcb (continued)

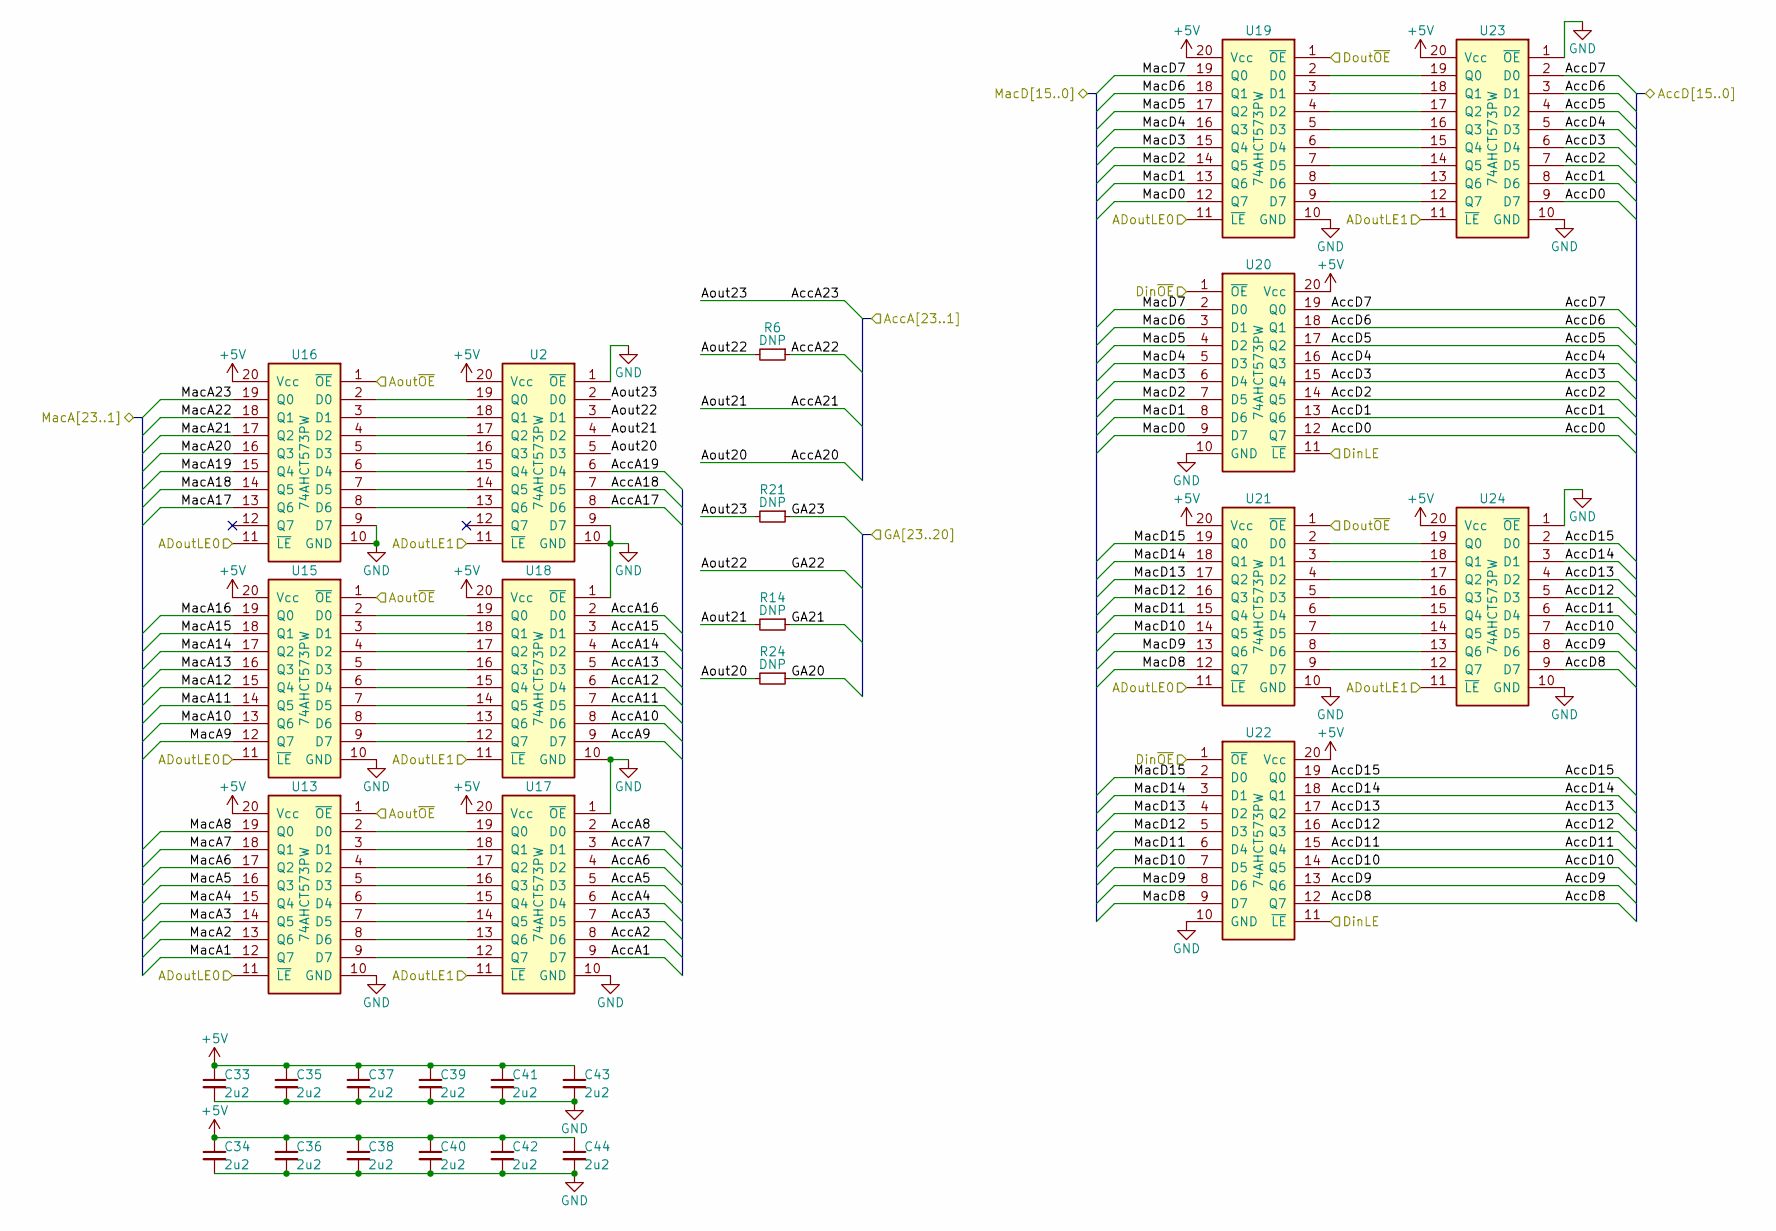
[picture p20: schematic Buf.kicad_sch, WarpSE (GW4410A)]

Parts:
C33, C34, C35, C36, C37, C38, C39, C40, C41, C42, C43, C44: 2u2; C_0603; LCSC Part C23630
R6, R14, R21, R24: DNP; R_0603
U2, U13, U15, U16, U17, U18, U19, U20, U21, U22, U23, U24: 74AHCT573PW; TSSOP-20_4.4x6.5mm_P0.65mm; LCSC Part C141311

Connections:
+5V: C33.1, C34.1, C35.1, C36.1, C37.1, C38.1, C39.1, C40.1, C41.1, C42.1, C43.1, C44.1, U2.20 (Vcc), U13.20 (Vcc), U15.20 (Vcc), U16.20 (Vcc), U17.20 (Vcc), U18.20 (Vcc), U19.20 (Vcc), U20.20 (Vcc), U21.20 (Vcc), U22.20 (Vcc), U23.20 (Vcc), U24.20 (Vcc); also elsewhere on the board
/Buf/ADoutLE0: U13.11 (~LE), U15.11 (~LE), U16.11 (~LE), U19.11 (~LE), U21.11 (~LE); also elsewhere on the board
/Buf/ADoutLE1: U2.11 (~LE), U17.11 (~LE), U18.11 (~LE), U23.11 (~LE), U24.11 (~LE); also elsewhere on the board
/Buf/AccA1: U17.9 (D7); also elsewhere on the board
/Buf/AccA2: U17.8 (D6); also elsewhere on the board
/Buf/AccA3: U17.7 (D5); also elsewhere on the board
/Buf/AccA4: U17.6 (D4); also elsewhere on the board
/Buf/AccA5: U17.5 (D3); also elsewhere on the board
/Buf/AccA6: U17.4 (D2); also elsewhere on the board
/Buf/AccA7: U17.3 (D1); also elsewhere on the board
/Buf/AccA8: U17.2 (D0); also elsewhere on the board
/Buf/AccA9: U18.9 (D7); also elsewhere on the board
/Buf/AccA10: U18.8 (D6); also elsewhere on the board
/Buf/AccA11: U18.7 (D5); also elsewhere on the board
/Buf/AccA12: U18.6 (D4); also elsewhere on the board
/Buf/AccA13: U18.5 (D3); also elsewhere on the board
/Buf/AccA14: U18.4 (D2); also elsewhere on the board
/Buf/AccA15: U18.3 (D1); also elsewhere on the board
/Buf/AccA16: U18.2 (D0); also elsewhere on the board
/Buf/AccA17: U2.8 (D6); also elsewhere on the board
/Buf/AccA18: U2.7 (D5); also elsewhere on the board
/Buf/AccA19: U2.6 (D4); also elsewhere on the board
/Buf/AccA20: R24.2, U2.5 (D3); also elsewhere on the board
/Buf/AccA21: R14.2, U2.4 (D2); also elsewhere on the board
/Buf/AccA22: R6.1; also elsewhere on the board
/Buf/AccA23: R21.2, U2.2 (D0); also elsewhere on the board
/Buf/AccD0: U20.12 (Q7), U23.9 (D7); also elsewhere on the board
/Buf/AccD1: U20.13 (Q6), U23.8 (D6); also elsewhere on the board
/Buf/AccD2: U20.14 (Q5), U23.7 (D5); also elsewhere on the board
/Buf/AccD3: U20.15 (Q4), U23.6 (D4); also elsewhere on the board
/Buf/AccD4: U20.16 (Q3), U23.5 (D3); also elsewhere on the board
/Buf/AccD5: U20.17 (Q2), U23.4 (D2); also elsewhere on the board
/Buf/AccD6: U20.18 (Q1), U23.3 (D1); also elsewhere on the board
/Buf/AccD7: U20.19 (Q0), U23.2 (D0); also elsewhere on the board
/Buf/AccD8: U22.12 (Q7), U24.9 (D7); also elsewhere on the board
/Buf/AccD9: U22.13 (Q6), U24.8 (D6); also elsewhere on the board
/Buf/AccD10: U22.14 (Q5), U24.7 (D5); also elsewhere on the board
/Buf/AccD11: U22.15 (Q4), U24.6 (D4); also elsewhere on the board
/Buf/AccD12: U22.16 (Q3), U24.5 (D3); also elsewhere on the board
/Buf/AccD13: U22.17 (Q2), U24.4 (D2); also elsewhere on the board
/Buf/AccD14: U22.18 (Q1), U24.3 (D1); also elsewhere on the board
/Buf/AccD15: U22.19 (Q0), U24.2 (D0); also elsewhere on the board
/Buf/Aout~OE: U13.1 (~OE), U15.1 (~OE), U16.1 (~OE); also elsewhere on the board
/Buf/DinLE: U20.11 (~LE), U22.11 (~LE); also elsewhere on the board
/Buf/Din~OE: U20.1 (~OE), U22.1 (~OE); also elsewhere on the board
/Buf/Dout~OE: U19.1 (~OE), U21.1 (~OE); also elsewhere on the board
/Buf/GA20: R24.1; also elsewhere on the board
/Buf/GA21: R14.1; also elsewhere on the board
/Buf/GA22: R6.2, U2.3 (D1); also elsewhere on the board
/Buf/GA23: R21.1; also elsewhere on the board
/Buf/MacA1: U13.12 (Q7); also elsewhere on the board
/Buf/MacA2: U13.13 (Q6); also elsewhere on the board
/Buf/MacA3: U13.14 (Q5); also elsewhere on the board
/Buf/MacA4: U13.15 (Q4); also elsewhere on the board
/Buf/MacA5: U13.16 (Q3); also elsewhere on the board
/Buf/MacA6: U13.17 (Q2); also elsewhere on the board
/Buf/MacA7: U13.18 (Q1); also elsewhere on the board
/Buf/MacA8: U13.19 (Q0); also elsewhere on the board
/Buf/MacA9: U15.12 (Q7); also elsewhere on the board
/Buf/MacA10: U15.13 (Q6); also elsewhere on the board
/Buf/MacA11: U15.14 (Q5); also elsewhere on the board
/Buf/MacA12: U15.15 (Q4); also elsewhere on the board
/Buf/MacA13: U15.16 (Q3); also elsewhere on the board
/Buf/MacA14: U15.17 (Q2); also elsewhere on the board
/Buf/MacA15: U15.18 (Q1); also elsewhere on the board
/Buf/MacA16: U15.19 (Q0); also elsewhere on the board
/Buf/MacA17: U16.13 (Q6); also elsewhere on the board
/Buf/MacA18: U16.14 (Q5); also elsewhere on the board
/Buf/MacA19: U16.15 (Q4); also elsewhere on the board
/Buf/MacA20: U16.16 (Q3); also elsewhere on the board
/Buf/MacA21: U16.17 (Q2); also elsewhere on the board
/Buf/MacA22: U16.18 (Q1); also elsewhere on the board
/Buf/MacA23: U16.19 (Q0); also elsewhere on the board
/Buf/MacD0: U19.12 (Q7), U20.9 (D7); also elsewhere on the board
/Buf/MacD1: U19.13 (Q6), U20.8 (D6); also elsewhere on the board
/Buf/MacD2: U19.14 (Q5), U20.7 (D5); also elsewhere on the board
/Buf/MacD3: U19.15 (Q4), U20.6 (D4); also elsewhere on the board
/Buf/MacD4: U19.16 (Q3), U20.5 (D3); also elsewhere on the board
/Buf/MacD5: U19.17 (Q2), U20.4 (D2); also elsewhere on the board
/Buf/MacD6: U19.18 (Q1), U20.3 (D1); also elsewhere on the board
/Buf/MacD7: U19.19 (Q0), U20.2 (D0); also elsewhere on the board
/Buf/MacD8: U21.12 (Q7), U22.9 (D7); also elsewhere on the board
/Buf/MacD9: U21.13 (Q6), U22.8 (D6); also elsewhere on the board
/Buf/MacD10: U21.14 (Q5), U22.7 (D5); also elsewhere on the board
/Buf/MacD11: U21.15 (Q4), U22.6 (D4); also elsewhere on the board
/Buf/MacD12: U21.16 (Q3), U22.5 (D3); also elsewhere on the board
/Buf/MacD13: U21.17 (Q2), U22.4 (D2); also elsewhere on the board
/Buf/MacD14: U21.18 (Q1), U22.3 (D1); also elsewhere on the board
/Buf/MacD15: U21.19 (Q0), U22.2 (D0); also elsewhere on the board
GND: C33.2, C34.2, C35.2, C36.2, C37.2, C38.2, C39.2, C40.2, C41.2, C42.2, C43.2, C44.2, U2.1 (~OE), U2.9 (D7), U2.10 (GND), U13.10 (GND), U15.10 (GND), U16.9 (D7), U16.10 (GND), U17.1 (~OE), U17.10 (GND), U18.1 (~OE), U18.10 (GND), U19.10 (GND), U20.10 (GND), U21.10 (GND), U22.10 (GND), U23.1 (~OE), U23.10 (GND), U24.1 (~OE), U24.10 (GND); also elsewhere on the board
unnamed: U13.2 (D0), U17.19 (Q0)
unnamed: U13.3 (D1), U17.18 (Q1)
unnamed: U13.4 (D2), U17.17 (Q2)
unnamed: U13.5 (D3), U17.16 (Q3)
unnamed: U13.6 (D4), U17.15 (Q4)
unnamed: U13.7 (D5), U17.14 (Q5)
unnamed: U13.8 (D6), U17.13 (Q6)
unnamed: U13.9 (D7), U17.12 (Q7)
unnamed: U15.2 (D0), U18.19 (Q0)
unnamed: U15.3 (D1), U18.18 (Q1)
unnamed: U15.4 (D2), U18.17 (Q2)
unnamed: U15.5 (D3), U18.16 (Q3)
unnamed: U15.6 (D4), U18.15 (Q4)
unnamed: U15.7 (D5), U18.14 (Q5)
unnamed: U15.8 (D6), U18.13 (Q6)
unnamed: U15.9 (D7), U18.12 (Q7)
unnamed: U2.19 (Q0), U16.2 (D0)
unnamed: U2.18 (Q1), U16.3 (D1)
unnamed: U2.17 (Q2), U16.4 (D2)
unnamed: U2.16 (Q3), U16.5 (D3)
unnamed: U2.15 (Q4), U16.6 (D4)
unnamed: U2.14 (Q5), U16.7 (D5)
unnamed: U2.13 (Q6), U16.8 (D6)
unnamed: U19.2 (D0), U23.19 (Q0)
unnamed: U19.3 (D1), U23.18 (Q1)
unnamed: U19.4 (D2), U23.17 (Q2)
unnamed: U19.5 (D3), U23.16 (Q3)
unnamed: U19.6 (D4), U23.15 (Q4)
unnamed: U19.7 (D5), U23.14 (Q5)
unnamed: U19.8 (D6), U23.13 (Q6)
unnamed: U19.9 (D7), U23.12 (Q7)
unnamed: U21.2 (D0), U24.19 (Q0)
unnamed: U21.3 (D1), U24.18 (Q1)
unnamed: U21.4 (D2), U24.17 (Q2)
unnamed: U21.5 (D3), U24.16 (Q3)
unnamed: U21.6 (D4), U24.15 (Q4)
unnamed: U21.7 (D5), U24.14 (Q5)
unnamed: U21.8 (D6), U24.13 (Q6)
unnamed: U21.9 (D7), U24.12 (Q7)

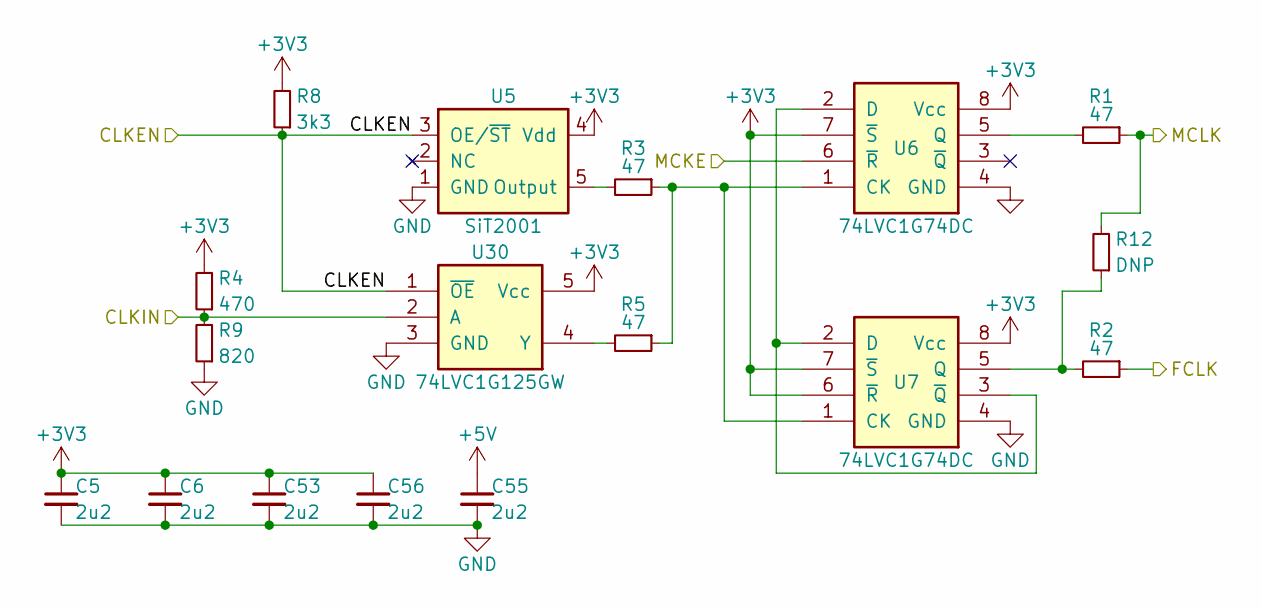
[picture p21: schematic Clk.kicad_sch, WarpSE (GW4410A)]

Parts:
C5, C6, C53, C55, C56: 2u2; C_0603; LCSC Part C23630
R1, R2, R3, R5: 47; R_0603; LCSC Part C23182
R4: 470; R_0603; LCSC Part C21190
R8: 3k3; R_0603; LCSC Part C21190
R9: 820; R_0603; LCSC Part C21190
R12: DNP; R_0603
U5: SiT2001; SOT-23-5; LCSC Part C17253174
U6, U7: 74LVC1G74DC; NXP_VSSOP-8_2.3x2mm; LCSC Part C503431
U30: 74LVC1G125GW; SOT-353; LCSC Part C12519

Connections:
+3V3: C5.1, C6.1, C53.1, C56.1, R4.2, R8.2, U5.4 (Vdd), U6.7 (~S), U6.8 (Vcc), U7.6 (~R), U7.7 (~S), U7.8 (Vcc), U30.5 (Vcc); also elsewhere on the board
+5V: C55.1; also elsewhere on the board
/Clk.sch/CLKEN: R8.1, U5.3 (OE/~ST), U30.1 (~OE); also elsewhere on the board
/Clk.sch/CLKIN: R4.1, R9.2, U30.2 (A); also elsewhere on the board
/Clk.sch/FCLK: R2.1; also elsewhere on the board
/Clk.sch/MCKE: U6.6 (~R); also elsewhere on the board
/Clk.sch/MCLK: R1.1, R12.2; also elsewhere on the board
GND: C5.2, C6.2, C53.2, C55.2, C56.2, R9.1, U5.1 (GND), U6.4 (GND), U7.4 (GND), U30.3 (GND); also elsewhere on the board
unnamed: R3.2, U5.5 (Output)
unnamed: R3.1, R5.1, U6.1 (CK), U7.1 (CK)
unnamed: U6.2 (D), U7.2 (D), U7.3 (~Q)
unnamed: R1.2, U6.5 (Q)
unnamed: R2.2, R12.1, U7.5 (Q)
unnamed: R5.2, U30.4 (Y)

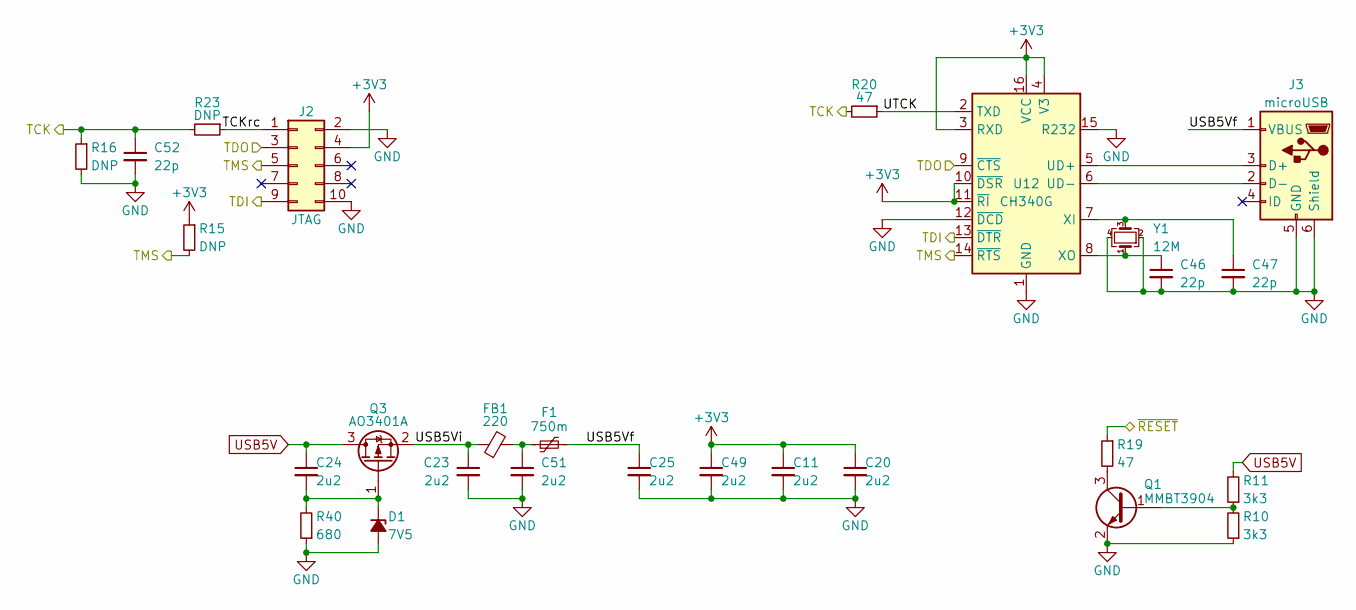
[picture p22: schematic Prog.kicad_sch, WarpSE (GW4410A)]

Parts:
C11, C20, C23, C24, C25, C49, C51: 2u2; C_0603; LCSC Part C23630
C46, C47, C52: 22p; C_0603; LCSC Part C1653
D1: 7V5; D_SOD-323; LCSC Part C95638
F1: 750m; BelFuse_1206; LCSC Part C126818
FB1: 220; C_0805; LCSC Part C85840
J2: JTAG; Tag-Connect_TC2050-IDC-FP_2x05_P1.27mm_Vertical
J3: microUSB; USB_Micro-B_Amphenol_10118192-0001; LCSC Part C132564
Q1: MMBT3904; SOT-23; LCSC Part C20526
Q3: AO3401A; SOT-23
R10, R11: 3k3; R_0603; LCSC Part C21190
R15, R16, R23: DNP; R_0603
R19, R20: 47; R_0603; LCSC Part C23182
R40: 680; R_0805; LCSC Part C17798
U12: CH340G; SOIC-16_3.9mm; LCSC Part C14267
Y1: 12M; Crystal_SMD_3225-4Pin_3.2x2.5mm; LCSC Part C9002

Connections:
+3V3: C11.1, C20.1, C49.1, J2.4, R15.1, U12.3 (RXD), U12.4 (V3), U12.10 (~DSR), U12.11 (~RI), U12.16 (VCC); also elsewhere on the board
/Control/TCK: C52.1, R16.1, R20.2, R23.2; also elsewhere on the board
/Control/TDI: J2.9, U12.13 (~DTR); also elsewhere on the board
/Control/TDO: J2.3, U12.9 (~CTS); also elsewhere on the board
/Control/TMS: J2.5, R15.2, U12.14 (~RTS); also elsewhere on the board
/Control/~RESET: R19.1; also elsewhere on the board
/Prog/TCKrc: J2.1, R23.1
/Prog/USB5Vf: C25.1, F1.2, J3.1 (VBUS)
/Prog/USB5Vi: C23.1, FB1.1, Q3.2 (S)
/Prog/UTCK: R20.1, U12.2 (TXD)
GND: C11.2, C20.2, C23.2, C25.2, C46.2, C47.2, C49.2, C51.2, C52.2, D1.2 (A), J2.2, J2.10, J3.5 (GND), J3.6 (Shield), Q1.2 (E), R10.1, R16.2, R40.1, U12.1 (GND), U12.12 (~DCD), U12.15 (R232), Y1.2, Y1.4; also elsewhere on the board
unnamed: C51.1, F1.1, FB1.2
unnamed: C24.2, D1.1 (K), Q3.1 (G), R40.2
unnamed: J3.3 (D+), U12.5 (UD+)
unnamed: J3.2 (D-), U12.6 (UD-)
unnamed: Q1.1 (B), R10.2, R11.1
unnamed: Q1.3 (C), R19.2
unnamed: C47.1, U12.7 (XI), Y1.3
unnamed: C46.1, U12.8 (XO), Y1.1
USB5V: C24.1, Q3.3 (D), R11.2; also elsewhere on the board

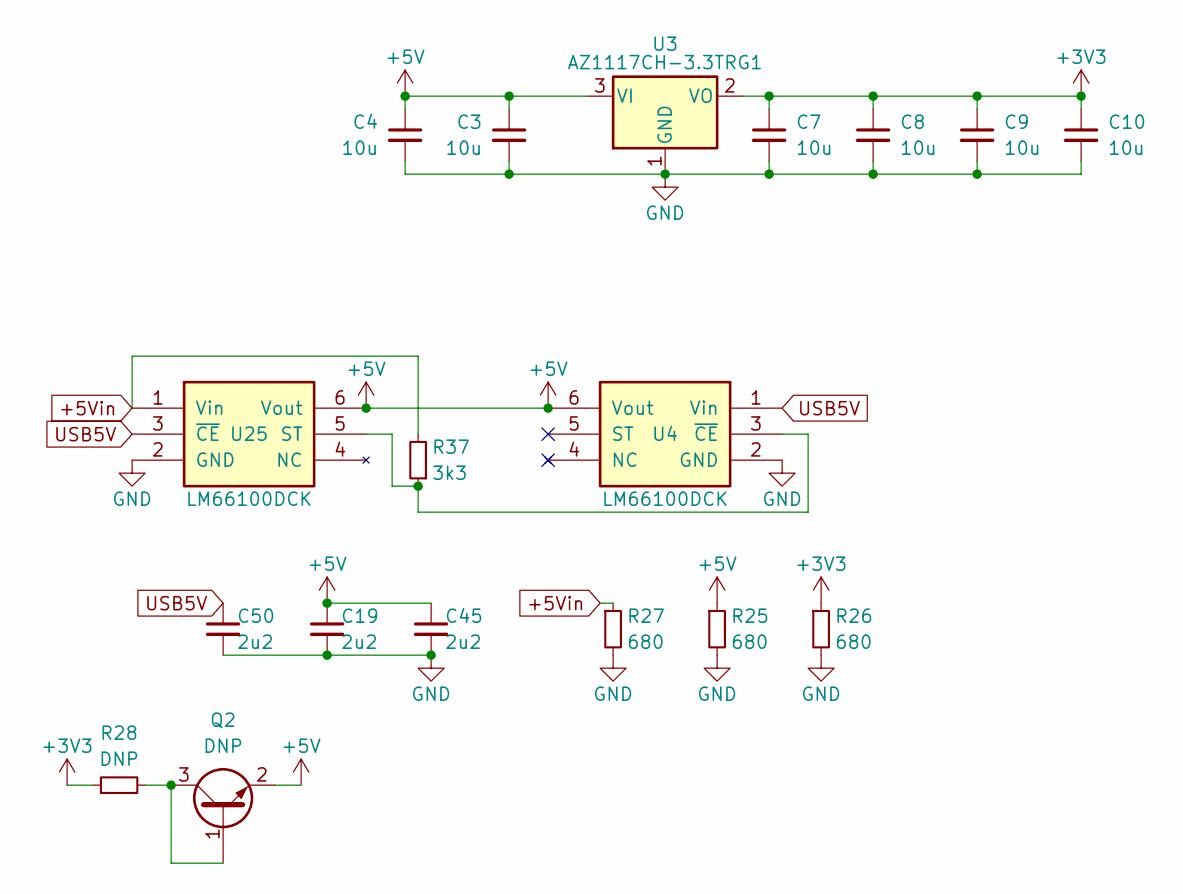
[picture p23: schematic Power.kicad_sch, WarpSE (GW4410A)]

Parts:
C3, C4, C7, C8, C9, C10: 10u; C_0805; LCSC Part C15850
C19, C45, C50: 2u2; C_0603; LCSC Part C23630
Q2: DNP; SOT-23
R25, R26, R27: 680; R_0805; LCSC Part C17798
R28: DNP; R_0805
R37: 3k3; R_0603; LCSC Part C21190
U3: AZ1117CH-3.3TRG1; SOT-223; LCSC Part C92102
U4, U25: LM66100DCK; SOT-363; LCSC Part C2869734

Connections:
+3V3: C7.1, C8.1, C9.1, C10.1, R26.1, R28.1, U3.2 (VO); also elsewhere on the board
+5V: C3.1, C4.1, C19.1, C45.1, Q2.2 (E), R25.1, U3.3 (VI), U4.6 (Vout), U25.6 (Vout); also elsewhere on the board
+5Vin: R27.1, R37.2, U25.1 (Vin); also elsewhere on the board
GND: C3.2, C4.2, C7.2, C8.2, C9.2, C10.2, C19.2, C45.2, C50.2, R25.2, R26.2, R27.2, U3.1 (GND), U4.2 (GND), U25.2 (GND); also elsewhere on the board
unnamed: Q2.1 (B), Q2.3 (C), R28.2
unnamed: R37.1, U4.3 (~CE), U25.5 (ST)
USB5V: C50.1, U4.1 (Vin), U25.3 (~CE); also elsewhere on the board

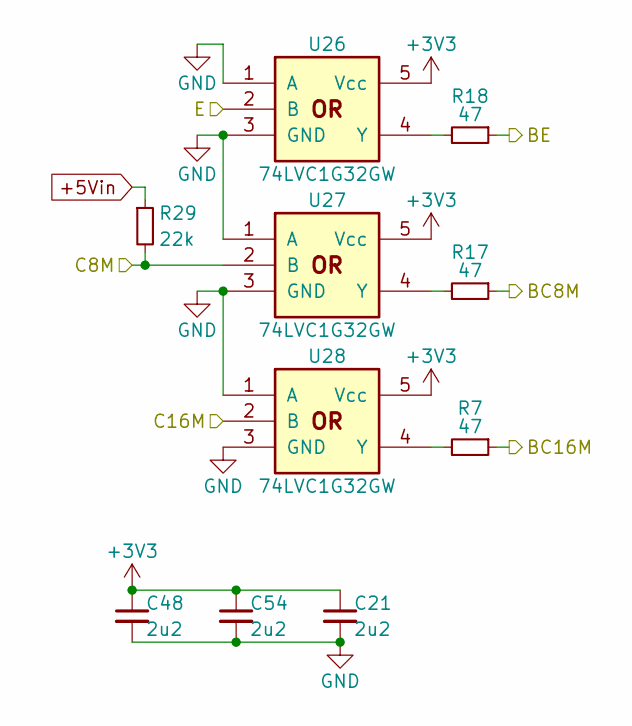
[picture p24: schematic ClkBuf.kicad_sch, WarpSE (GW4410A)]

Parts:
C21, C48, C54: 2u2; C_0603; LCSC Part C23630
R7, R17, R18: 47; R_0603; LCSC Part C23182
R29: 22k; R_0805; LCSC Part C17560
U26, U27, U28: 74LVC1G32GW; SOT-353; LCSC Part C12516

Connections:
+3V3: C21.1, C48.1, C54.1, U26.5 (Vcc), U27.5 (Vcc), U28.5 (Vcc); also elsewhere on the board
+5Vin: R29.1; also elsewhere on the board
/ClkBuf/BC8M: R17.1; also elsewhere on the board
/ClkBuf/BC16M: R7.1; also elsewhere on the board
/ClkBuf/BE: R18.1; also elsewhere on the board
/ClkBuf/C8M: R29.2, U27.2 (B); also elsewhere on the board
/ClkBuf/C16M: U28.2 (B); also elsewhere on the board
/ClkBuf/E: U26.2 (B); also elsewhere on the board
GND: C21.2, C48.2, C54.2, U26.1 (A), U26.3 (GND), U27.1 (A), U27.3 (GND), U28.1 (A), U28.3 (GND); also elsewhere on the board
unnamed: R18.2, U26.4 (Y)
unnamed: R17.2, U27.4 (Y)
unnamed: R7.2, U28.4 (Y)

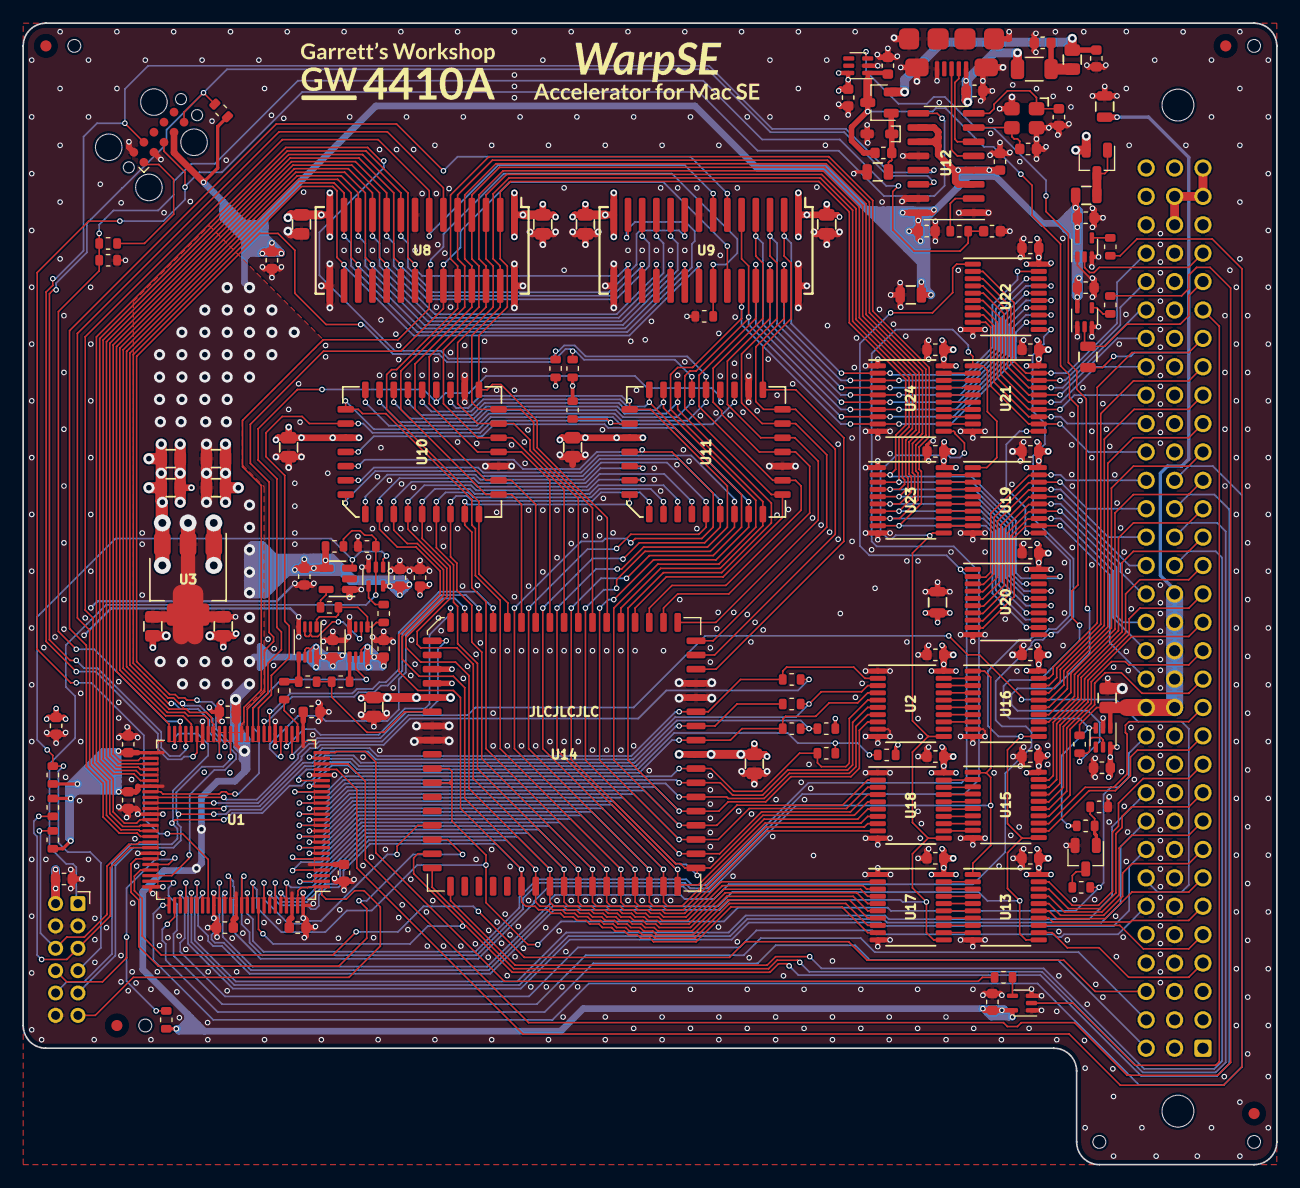
[picture p25: board WarpSE.kicad_pcb from above]

Board: 4 copper layers, 112.1 x 102.1 mm, 144 parts (0 on the bottom side), 215 nets.
