garrettsworkshop/WarpSE/(commit log)

2021-10-29 add from other repo
    [Buf.sch, Clk.sch, Control.sch, DIPSW.sch, JTAG.sch, MC68k.sch, PDS.sch, Power.sch]
2021-11-02 Update SE-030.kicad_pcb
    More via stitching
    [SE-030.kicad_pcb]
2021-11-20 Documentation update
    [SE-030.kicad_pcb]
2022-01-03 Before I remove ESP32
    [Buf.sch, Control.sch, DIPSW.sch, JTAG.sch, MC68k.sch, PDS.sch, Power.sch, Prog.sch]
2022-01-27 Moving toward new update system
    [Buf.sch, Clk.sch, Control.sch, DIPSW.sch, MC68k.sch, PDS.sch, Power.sch, Prog.sch]
2022-02-01 Migrate to KiCad 6
    [Buf.kicad_sch, Buf.sch, Clk.kicad_sch, Clk.sch, Control.kicad_sch, Control.sch, DIPSW.kicad_sch, DIPSW.sch]
2022-03-29 Better CPLD stuff
    [MXSE_pad.csv, WarpSE_pad.csv]
2022-04-06 Add power adapter
    [SEPowerAdapter.kicad_pcb, SEPowerAdapter.kicad_sch]
2022-04-12 More work on power adapter
    [SEPowerAdapter.kicad_pcb, SEPowerAdapter.kicad_sch]
2022-04-19 Ignore kicad_prl files
2022-04-19 With new logo
    [WarpSE-B_Cu.gbl, WarpSE-B_Mask.gbs, WarpSE-B_Paste.gbp, WarpSE-B_Silkscreen.gbo, WarpSE-Edge_Cuts.gm1, WarpSE-F_Cu.gtl, WarpSE-F_Mask.gts, WarpSE-F_Paste.gtp]
2022-04-19 "Rotation" in top-pos
    [WarpSE-top-pos.csv]
2022-04-19 Correct orientation for ROM sockets
    [SEPowerAdapter.kicad_pcb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]
2022-04-19 Actually fix orientation
    [WarpSE-B_Cu.gbl, WarpSE-B_Mask.gbs, WarpSE-B_Paste.gbp, WarpSE-B_Silkscreen.gbo, WarpSE-Edge_Cuts.gm1, WarpSE-F_Cu.gtl, WarpSE-F_Mask.gts, WarpSE-F_Paste.gtp]
2022-04-22 Finished power adapter?
    [SEPowerAdapter-BOM.csv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]
2022-05-25 Power adapter as sent to JLC
    [SEPowerAdapter-B_Cu.gbl, SEPowerAdapter-B_Mask.gbs, SEPowerAdapter-B_Paste.gbp, SEPowerAdapter-B_Silkscreen.gbo, SEPowerAdapter-Edge_Cuts.gm1, SEPowerAdapter-F_Cu.gtl, SEPowerAdapter-F_Mask.gts, SEPowerAdapter-F_Paste.gtp]
2022-06-07 As sent to JLC
    [WarpSE-BOM.csv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]
2023-03-25 Starts up
    [WarpSE_pad.csv]
2023-03-25 Redo CNT timers
    [WarpSE_pad.csv]
2023-03-27 Put back all chip selects.
    [WarpSE_pad.csv]
2023-03-30 Fixing this up some more
    [SEPowerAdapter.kicad_pcb]
2023-04-01 Works well but fast RAM disabled
    [WarpSE_pad.csv]
2023-04-01 Better but RAM still not right... soldering error in prototype?
    [WarpSE_pad.csv]
2023-04-07 Works with new Ready. RAM still untested
    [WarpSE_pad.csv]
2023-04-07 RAM working!!
    [WarpSE_pad.csv]
2023-04-09 Sound QoS working?
    [WarpSE_pad.csv]
2023-04-10 Works. IOPWReady eliminated
    [WarpSE_pad.csv]
2023-04-10 Works well again with speculative RAM refresh
    [WarpSE_pad.csv]
2023-04-30 Toward final "A"
    [Buf.kicad_sch, Clk.kicad_sch, ClkBuf.kicad_sch, Control.kicad_sch, DIPSW.kicad_sch, MC68k.kicad_sch, PDS.kicad_sch, Power.kicad_sch]
2023-07-13 Fix some CPLD typos
    [WarpSE_pad.csv]
2023-07-16 Revert "idk"
    This reverts commit 06688d2caf5c826e128d92688927a007f94f5988.
    [WarpSE_pad.csv]
2023-07-16 Revert "Fix some CPLD typos"
    This reverts commit 0a532676a141ee53dff6ecefa9564a2b2a8f2338.
    [WarpSE_pad.csv]
2023-07-16 Revert "idk"
    This reverts commit aa30aa8a559ae1d3e965923a55380a6d00f93ea4.
    [Prog.kicad_sch, WarpSE.kicad_pcb]
2023-07-16 Works including credit-based sound slowdown
    works
    [WarpSE_pad.csv]
2023-09-28 Put back old Sound QoS... not debit-based
    [WarpSE_pad.csv]
2023-11-07 final version?
    [Clk.kicad_sch, ClkBuf.kicad_sch, Power.kicad_sch, Prog.kicad_sch]
2023-11-07 toward final
    [Control.kicad_sch, Prog.kicad_sch]
2023-11-27 Remove power adapter
    [SEPowerAdapter-BOM.csv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]
2023-11-27 Update to new makefile, etc.
    [Buf.kicad_sch, Control.kicad_sch, WarpSE-BOM.csv]
2024-01-27 remove gerbers?
    [WarpSE-BOM.csv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]
2024-09-22 Fix bad wiring for CNT module
2024-09-22 Switch DBG to input to save macrocells
2024-09-22 Fix long timer comments -- no longer used for QoS
2024-09-22 USB power
    [Buf.kicad_sch, Clk.kicad_sch, ClkBuf.kicad_sch, Control.kicad_sch, MC68k.kicad_sch, PDS.kicad_sch, Power.kicad_sch, Prog.kicad_sch]
2024-09-22 New slowdown/QoS strategy -- everything goes out to the PDS bus
    [WarpSE_pad.csv]
2024-09-23 Remake project file
    [WarpSE_pad.csv]
2024-09-24 Fix I/O slowdown
    [WarpSE_pad.csv]
2024-09-26 Remake project again
    [WarpSE_pad.csv]
2024-09-29 New more cycle-accurate slowdown
    [WarpSE_pad.csv]
2024-09-29 Add LM66100 instead of MAX40200AUK
    [Power.kicad_sch, Prog.kicad_sch]
2024-09-30 Better sound, restore fast SCSI
    [WarpSE_pad.csv]
2024-10-01 simplifying CPLD functions, add IOB RW, slow SCSI back down
    [WarpSE_pad.csv]
2024-10-01 Works with simplified IOBS/IOBM
    [WarpSE_pad.csv]
2024-10-01 Remove MCKE gate and shorten POR
    [WarpSE_pad.csv]
2024-10-03 Board prerelease revision 3 with USB power, A[23:20] remapping
    [Buf.kicad_sch, ClkBuf.kicad_sch, Control.kicad_sch, PDS.kicad_sch, Power.kicad_sch, Prog.kicad_sch, WarpSE-BOM.csv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]
2024-10-03 Redo timers, init, QoS
2024-10-03 0.6a compiled and works
    [WarpSE_pad.csv]
2024-10-03 0.6b compiled and works
    [WarpSE_pad.csv]
2024-10-03 0.6c compiled and works
    [WarpSE_pad.csv]
2024-10-03 0.6d compiled and works
    [WarpSE_pad.csv]
2024-10-07 0.6e compiled and works
    [WarpSE_pad.csv]
2024-10-07 More /VMA setup time matching MC68k timing
    [WarpSE_pad.csv]
2024-10-07 0.6f compiled and working
    [WarpSE_pad.csv]
2024-10-09 Actually assign PDS R/W signal to I/O pin
2024-10-09 0.6g compiled. Should work but untested
    [WarpSE_pad.csv]
2024-10-09 0.6h compiled and working
    [WarpSE_pad.csv]
2024-10-09 0.6i compiled and working
    [WarpSE_pad.csv]
2024-10-11 Add settings module power-on reset
2024-10-11 0.7a compiled and working
    [WarpSE_pad.csv]
2024-10-11 0.7a-35us compiled
    [WarpSE_pad.csv]
2024-10-11 0.7a-slow compiled
    [WarpSE_pad.csv]
2024-10-11 0.7a-slow-noclockgate compiled
    [WarpSE_pad.csv]
2024-10-11 0.7a-fastscsi compiled
    [WarpSE_pad.csv]
2024-10-12 0.6a-noclockgate compiled
    [WarpSE_pad.csv]
2024-10-12 0.7a-35us-noclockgate compiled
    [WarpSE_pad.csv]
2024-10-12 0.7a-fast compiled
    [WarpSE_pad.csv]
2024-10-12 0.6a-fastscsi-noclockgate compiled
    [WarpSE_pad.csv]
2024-10-12 0.7a-fastscsi-35us-noclockgate compiled
    [WarpSE_pad.csv]
2024-10-12 0.7a-fastscsi-35us compiled
    [WarpSE_pad.csv]
2024-10-12 0.7a-fastiack compiled
    [WarpSE_pad.csv]
2024-10-12 0.7a-fastiack-35us compiled
    [WarpSE_pad.csv]
2024-10-12 0.7a-fastiack-noclockgate compiled
    [WarpSE_pad.csv]
2024-10-12 0.7a-fastiack-fastscsi-35us compiled
    [WarpSE_pad.csv]
2024-10-12 0.7a-fastiack-fastscsi-35us-noclockgate compiled
    [WarpSE_pad.csv]
2024-10-12 0.7a-fastiack-fastscsi-noclockgate compiled
    [WarpSE_pad.csv]
2024-10-12 0.7a-fastscc compiled
    [WarpSE_pad.csv]
2024-10-12 0.7a-fastscc-35us compiled
    [WarpSE_pad.csv]
2024-10-12 0.7a-fastscc-noclockgate compiled
    [WarpSE_pad.csv]
2024-10-12 0.7a-fastiack-fastscc compiled
    [WarpSE_pad.csv]
2024-10-12 0.7a-fastiack-fastscc-35us compiled
    [WarpSE_pad.csv]
2024-10-12 0.7a-fastiack-fastscc-35us-noclockgate compiled
    [WarpSE_pad.csv]
2024-10-12 0.7a-fastiack-fastscc-noclockgate compiled
    [WarpSE_pad.csv]
2024-10-12 0.7a-fastiack-fastscc-fastscsi compiled
    [WarpSE_pad.csv]
2024-10-12 0.7a-fastiack-fastscc-fastscsi-35us compiled
    [WarpSE_pad.csv]
2024-10-12 0.7a-fastiack-fastscc-fastscsi-35us-noclockgate compiled
    [WarpSE_pad.csv]
2024-10-12 0.7a-fastiack-fastscc-fastscsi-noclockgate compiled
    [WarpSE_pad.csv]
2024-10-12 put 0.7a source, .jed, etc back and recompile
    [WarpSE_pad.csv]
2024-10-14 0.7b compiled and working
    [WarpSE_pad.csv]
2024-10-15 0.7c compiled and working
    [WarpSE_pad.csv]
2024-10-15 0.7c-fast compiled and working
    [WarpSE_pad.csv]
2024-10-15 0.7c-slow compiled and working
    [WarpSE_pad.csv]
2024-10-15 Go back to 0.7c
    [WarpSE_pad.csv]
2024-10-16 0.7d compiled and working
    [WarpSE_pad.csv]
2024-10-17 Just one setting, whether sound accesses trigger slowdown
    [WarpSE_pad.csv]
2024-10-20 Add OC board
    [WarpSE-Overclocking-Board.kicad_pcb, WarpSE-Overclocking-Board.kicad_sch]
2024-10-20 Before switching to SiT2001 oscillator
    [Clk.kicad_sch, Control.kicad_sch, PDS.kicad_sch, Power.kicad_sch, Prog.kicad_sch, RAMROM.kicad_sch]
2024-10-22 Remove overclocking board
    [WarpSE-Overclocking-Board.kicad_pcb, WarpSE-Overclocking-Board.kicad_sch]
2024-10-22 Board changes
    [Clk.kicad_sch, Control.kicad_sch, RAMROM.kicad_sch, WarpSE.kicad_pcb, WarpSE.kicad_sch]
2024-10-22 Firmware changes for board changes
2024-10-23 Remove old CPLD stuff
    [WarpSE_pad.csv]
2024-10-26 Before remove first clock input buffer
    [Clk.kicad_sch, ClkBuf.kicad_sch, Control.kicad_sch, Power.kicad_sch, Prog.kicad_sch, RAMROM.kicad_sch, WarpSE.kicad_pcb]
2025-01-10 Final A?
    [Buf.kicad_sch, Clk.kicad_sch, ClkBuf.kicad_sch, Control.kicad_sch, MC68k.kicad_sch, PDS.kicad_sch, Power.kicad_sch, Prog.kicad_sch]
2025-03-30 just a schematic change?
    [WarpSE.kicad_sch]
